schwimmbot-create/combat-robot-v2/artifacts/config-ui-live-viewing.png

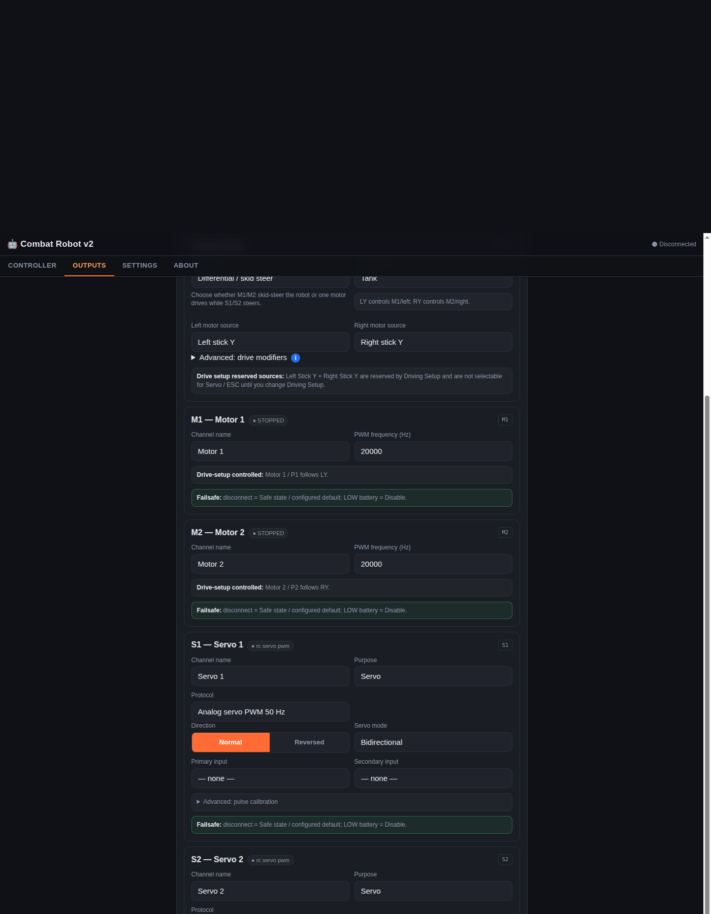
artifacts/config-ui-live-viewing.png
