schwimmbot-create/combat-robot-v2/artifacts/config-ui-sw1-failsafe.png

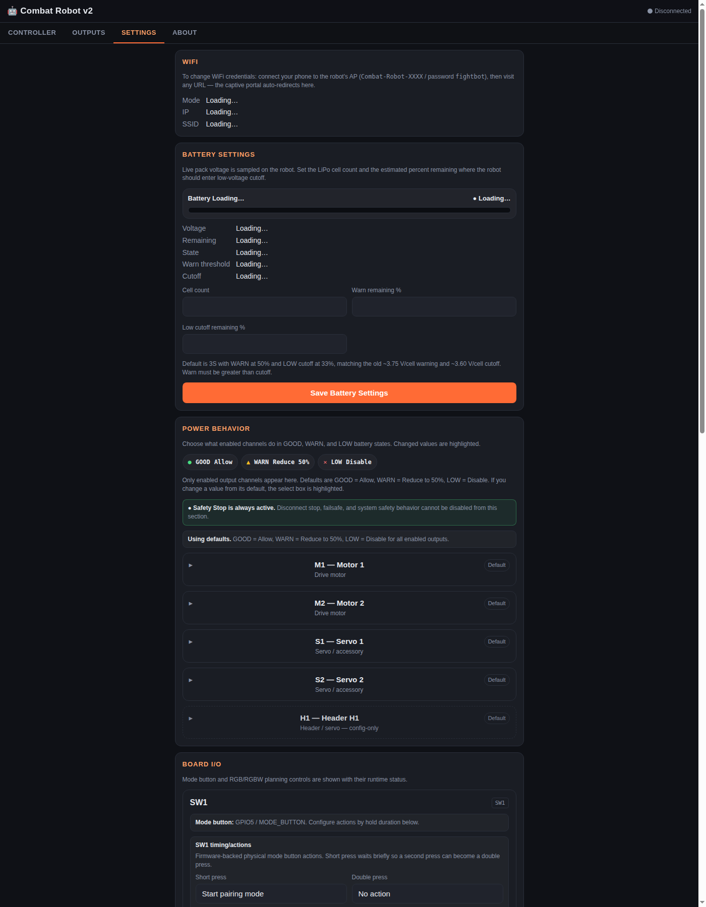
artifacts/config-ui-sw1-failsafe.png
