schwimmbot-create/combat-robot-v2/artifacts/drive-sim/bench-live.png

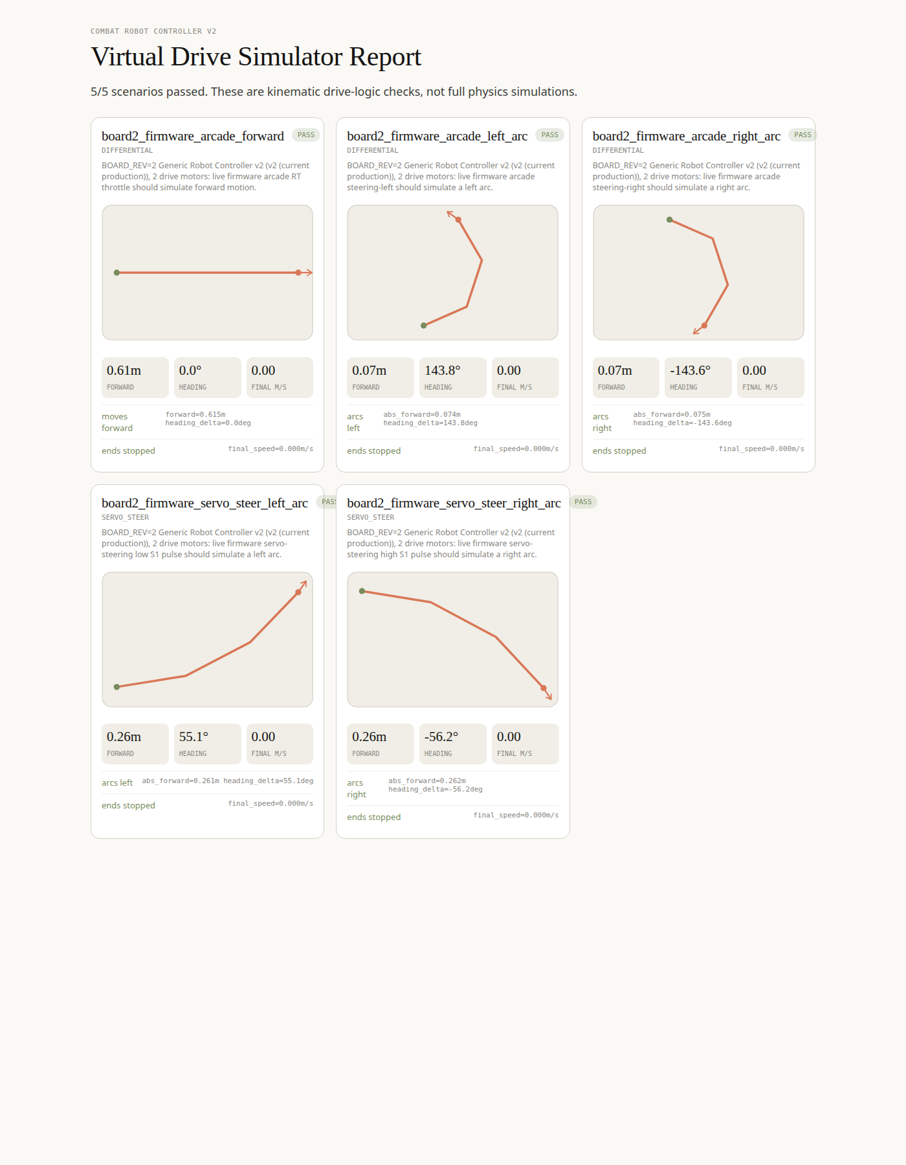
artifacts/drive-sim/bench-live.png
