schwimmbot-create/combat-robot-v2/artifacts/drive-sim/board-rev2.png

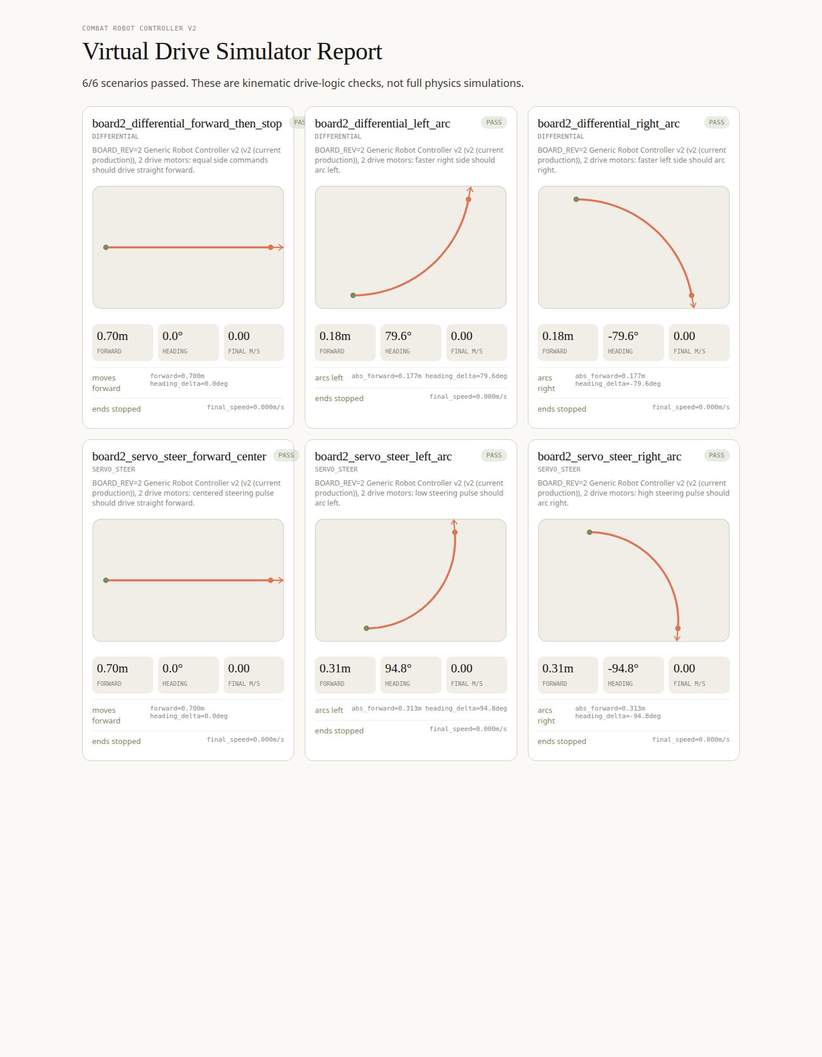
artifacts/drive-sim/board-rev2.png
