schwimmbot-create/combat-robot-v2/artifacts/drive-sim/latest.png

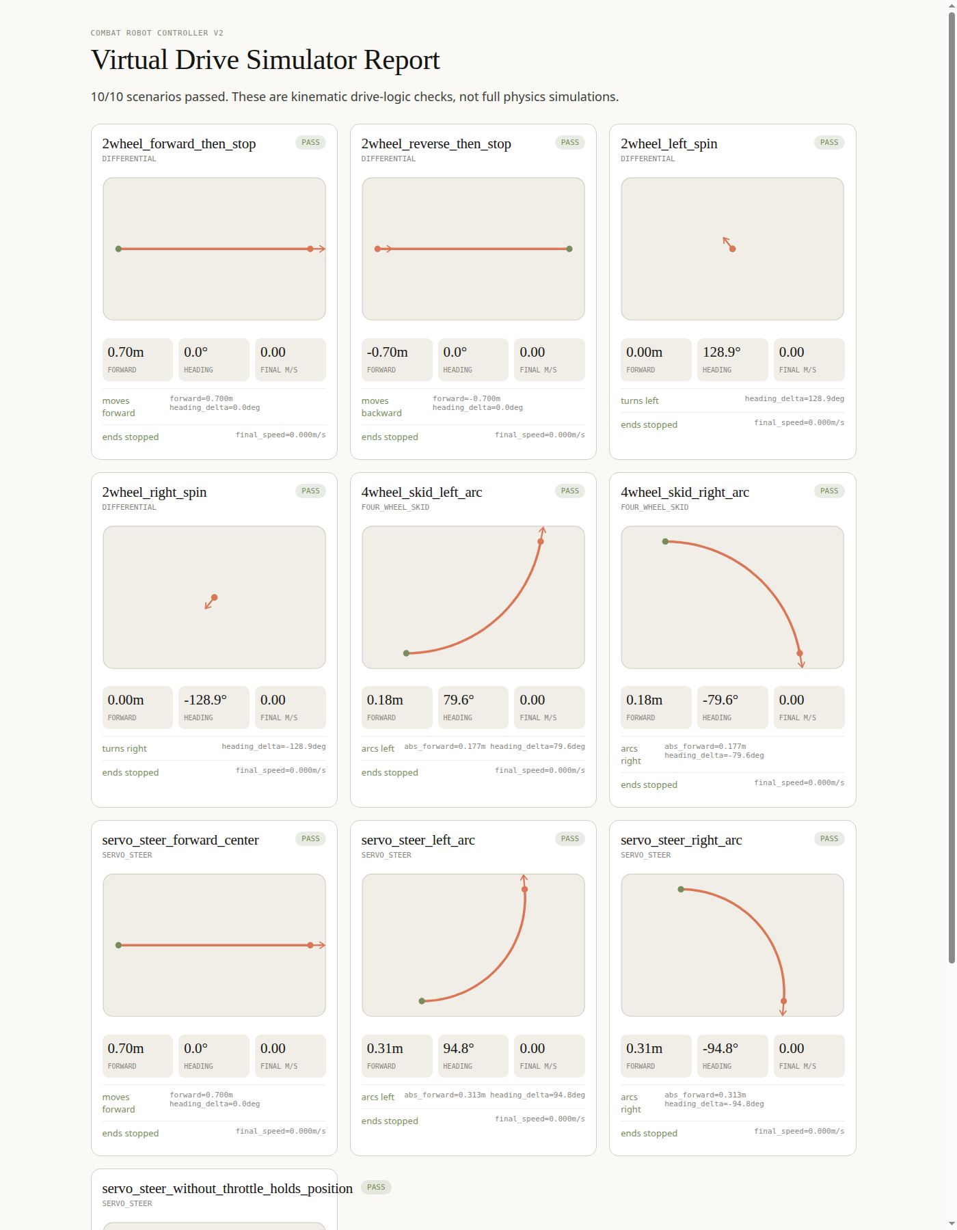
artifacts/drive-sim/latest.png
