schwimmbot-create/combat-robot-v2/docs/python-drive-testing-visual.html

Combat Robot Controller v2 · Python Drive Testing

# What the Python robot drive testing looks like

The current Python bench is a hardware-in-the-loop test harness: it drives a mock 8BitDo controller, pushes config through the robot API, reads serial status from the real robot controller, and asserts that firmware intent matches expected drive, motor, servo, power, and failsafe behavior.

396

software tests passing

PASS

PlatformIO build + upload

PASS

hardware bench e2e

90%

logic confidence without scope

## Current Python bench loop

This is what tools/bench_e2e.py does today.

## What Python asserts now

implementedhardware-in-loop

- Controller decoding: sticks, triggers, buttons, D-pad.
- Drive mixer: arcade, tank, D-pad virtual axes, precision, brake.
- Motor intent: M1/M2 speed, dir, fwd_duty, rev_duty, freq.
- Manual motor modes: momentary and latching.
- Servo/ESC pulse intent: S1/S2 pulse_us, duty, arming phase.
- Battery power behavior: GOOD full, WARN reduced, LOW disabled.
- Failsafe: disconnect stops drive motors.

Important: this does not measure voltage/waveforms with a scope. It proves the firmware's internal decision and output intent on real hardware.

## What a test case looks like

inject RT=50%, LX=left
expect drive_throttle > 200
expect drive_steering < -450
expect M1/M2 different speeds

status:
  drive={left:-253,right:511}
  motors={
    M1:{speed:125,dir:forward},
    M2:{speed:255,dir:reverse}
  }

PASS drive left stick steering mixes M1/M2

## Physical-drive extension: the visual part

The next layer is not just Python assertions. Python drives the exact same input script while a human/video confirms physical movement on a stand or marked floor.

## How the physical Python script should feel

Python step

Telemetry expected

Human/video expected

forward 1s

M1/M2 nonzero, same logical drive direction

robot would move straight forward

left turn 1s

left/right commands differ or oppose

robot yaws/arcs left

brake

drive left/right = 0, M1/M2 stop

all wheels stop

WARN override

drive command approximately half

wheel speed visibly reduced

disconnect

M1/M2 stop

robot stops safely
