schwimmbot-create/combat-robot-v2/docs/python-drive-testing-visual.png

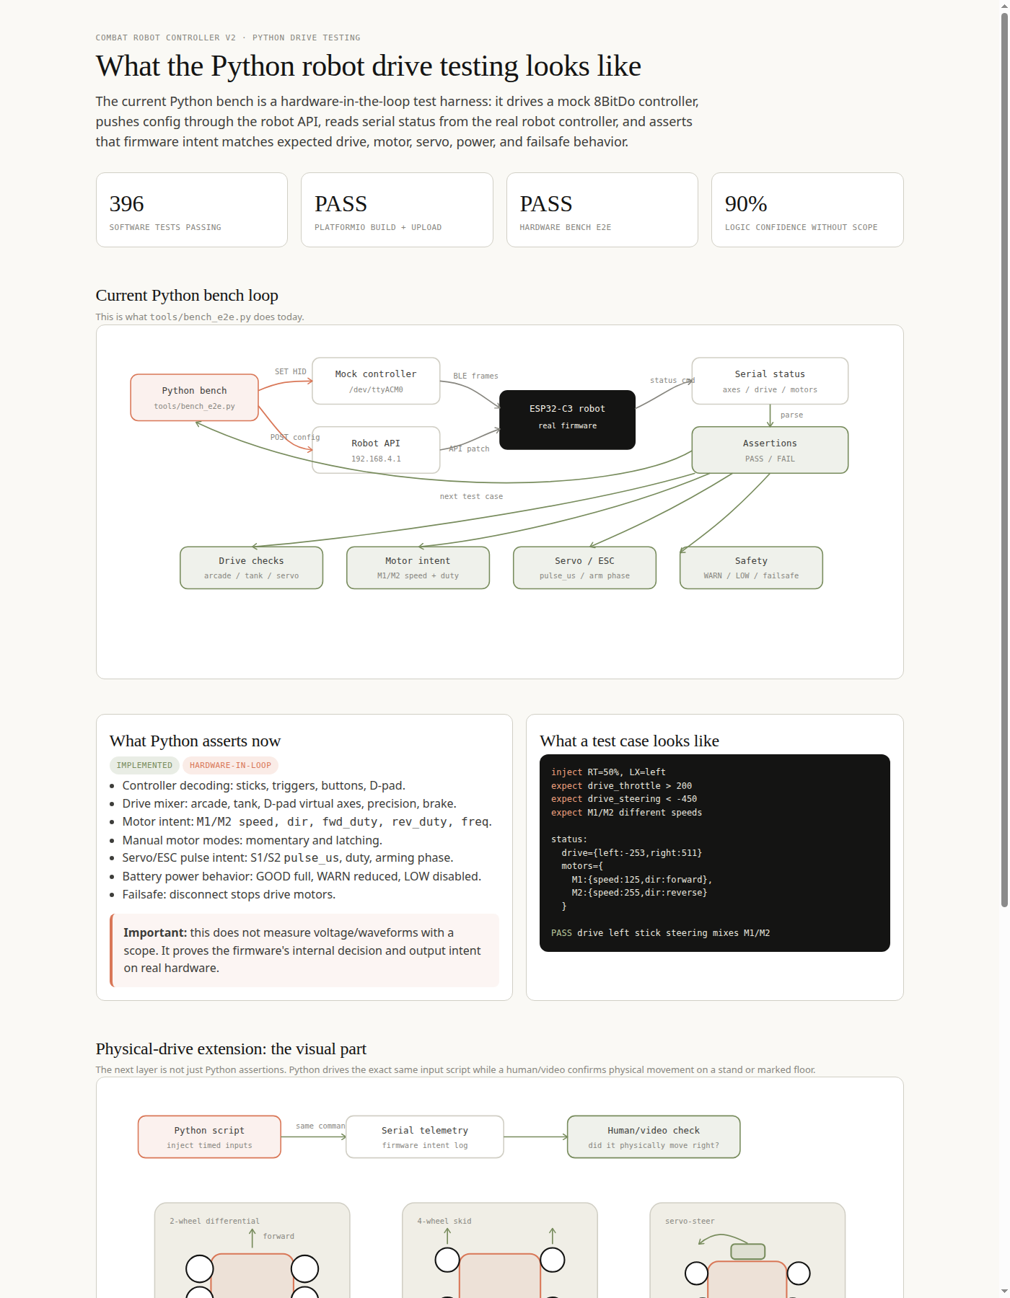
docs/python-drive-testing-visual.png
