schwimmbot-create/combat-robot-v2/hardware/board-v3-rev1-rendered.pdf

# USB Boot and Reset

3V3

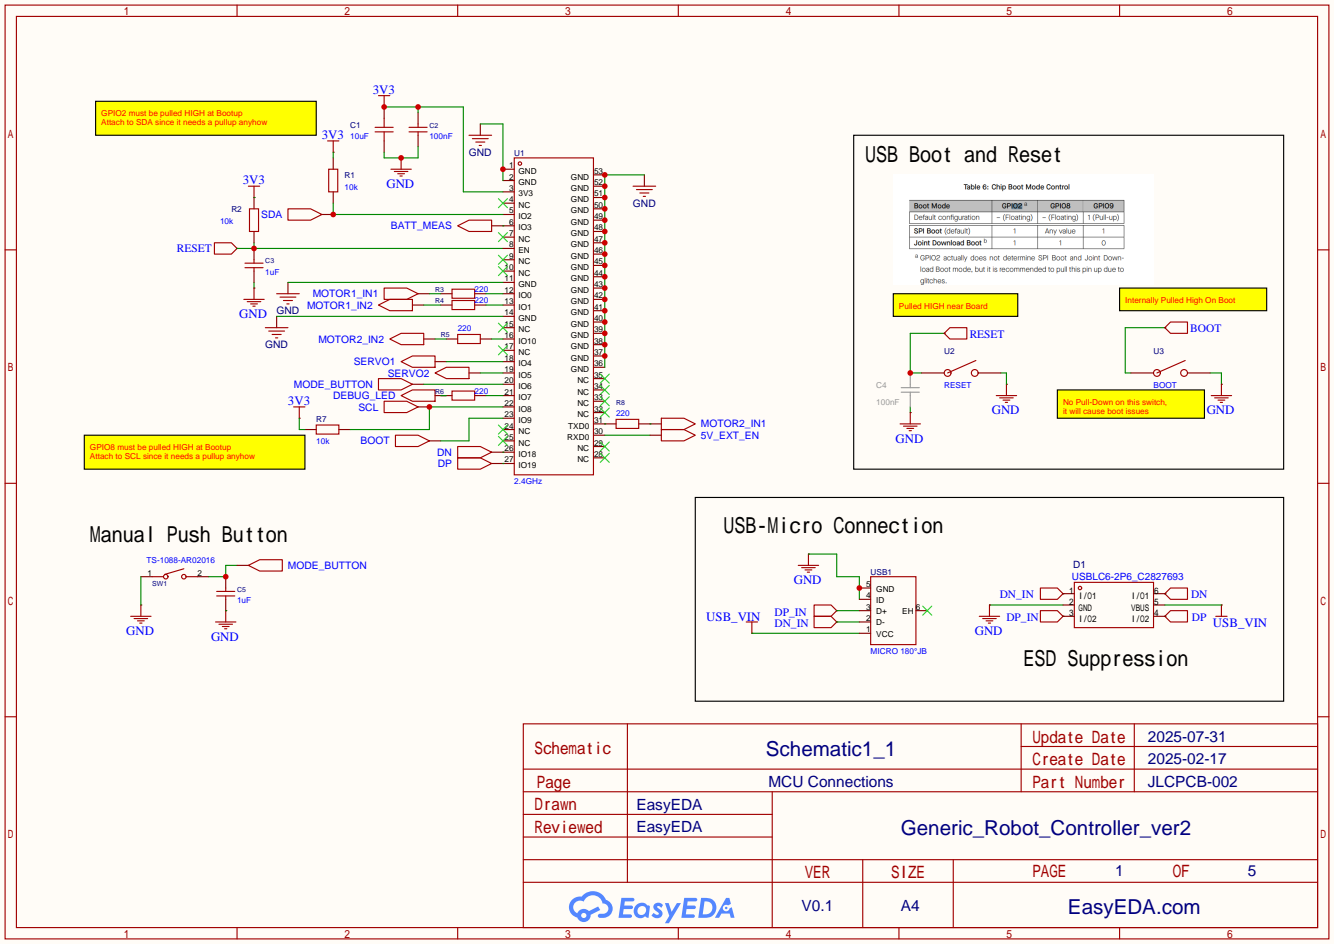
[picture p7: page 1]

GPIO2 must be pulled HIGH at Bootup
Attach to SDA since it needs a pullup anyhow

Pulled HIGH near Board

No Pull-Down on this switch,
it will cause boot issues

GPIO8 must be pulled HIGH at Bootup
Attach to SCL since it needs a pullup anyhow

# Battery Measurement WS2812 LED Supply

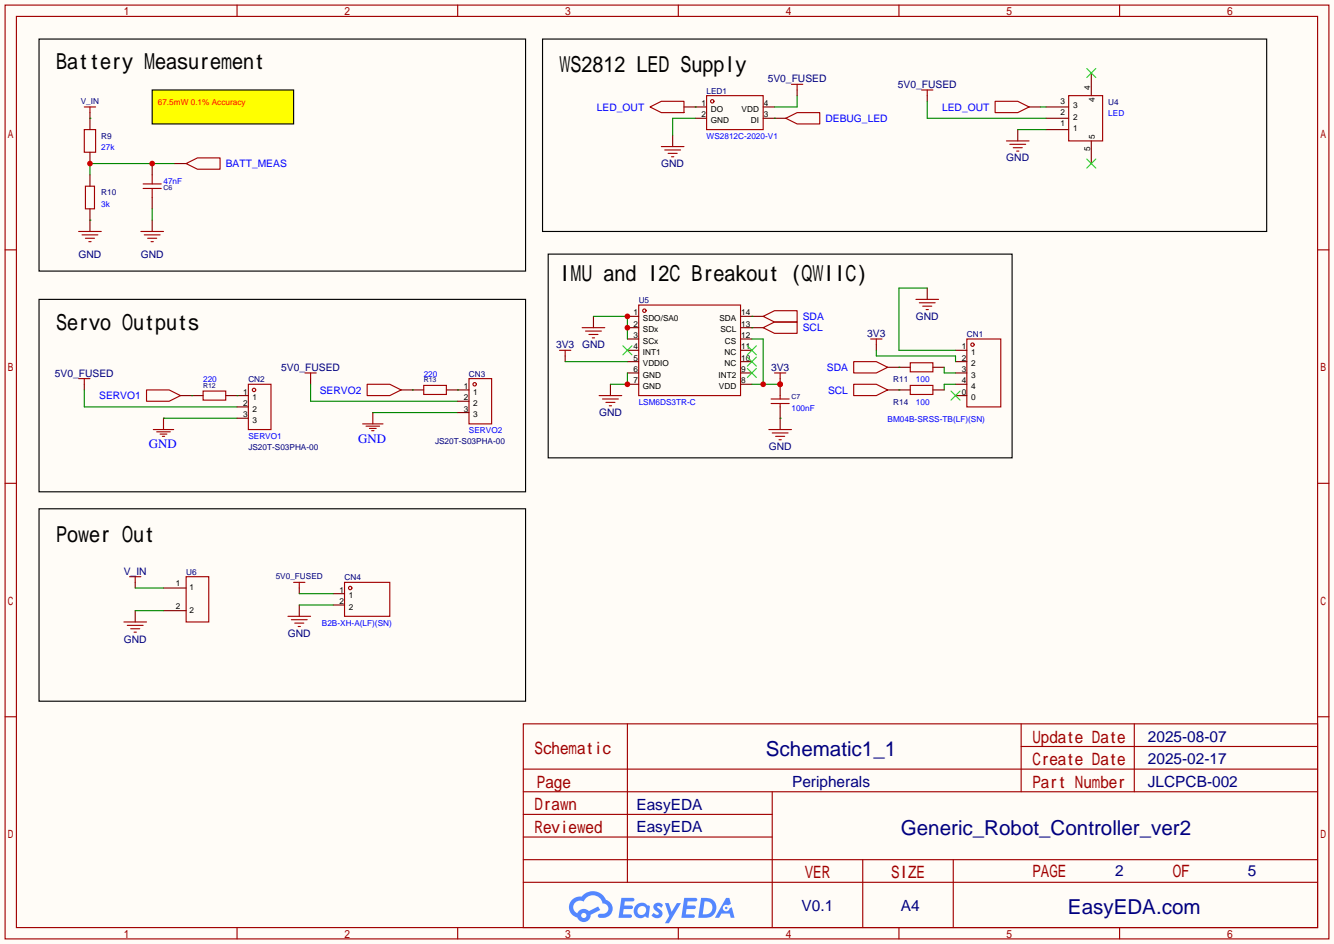
[picture p8: page 2]

IMU and I2C Breakout (QWIIC)

NC 10 NC 11 CS 12 SCL 13 SDA 14

BM04B-SRSS-TB(LF)(SN)

# Motor Drivers

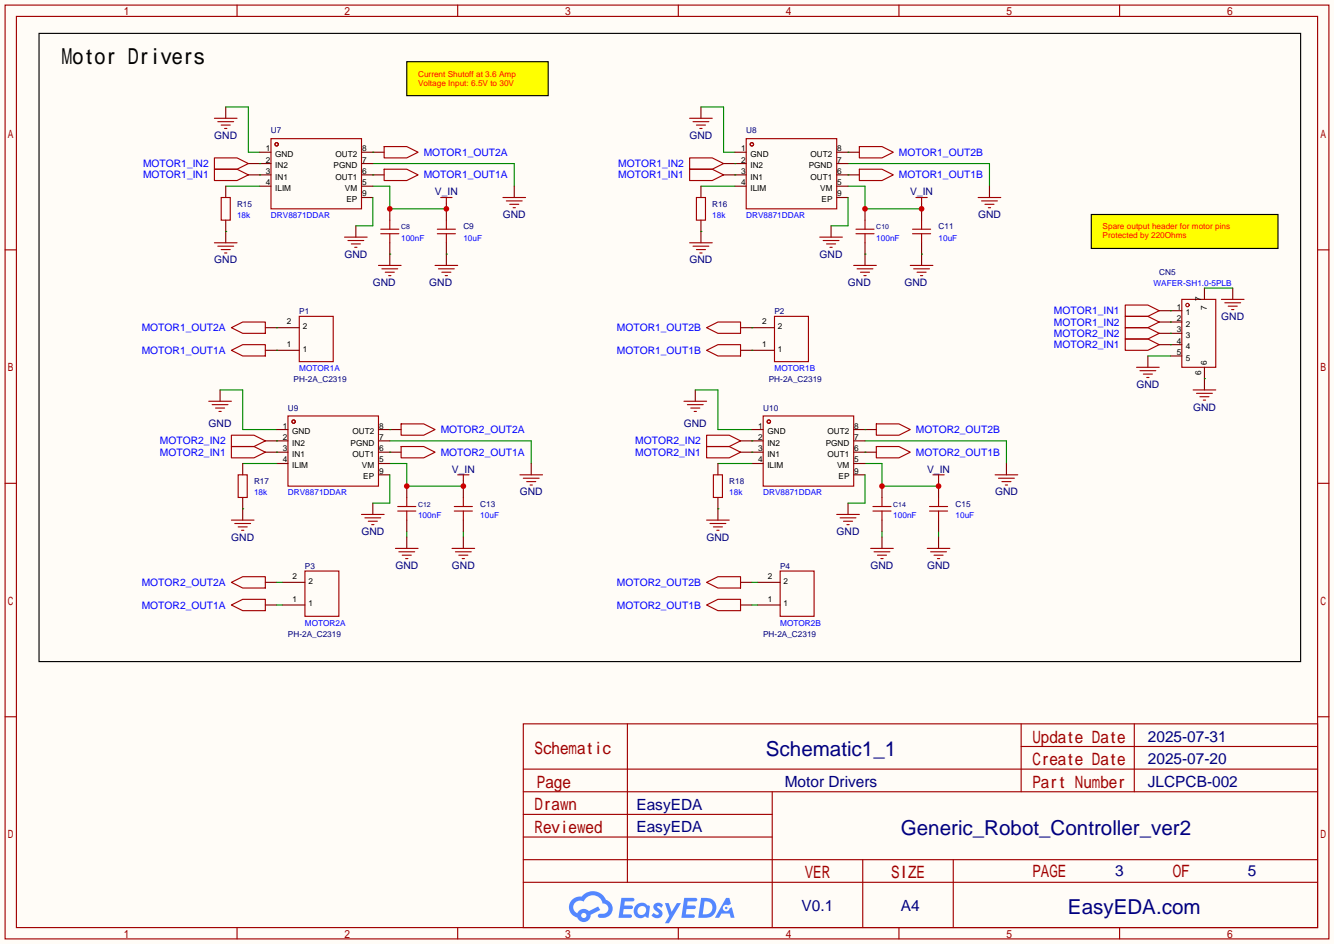
[picture p9: page 3]

Current Shutoff at 3.6 Amp
Voltage Input: 6.5V to 30V

Spare output header for motor pins
Protected by 220Ohms

# Power Protection

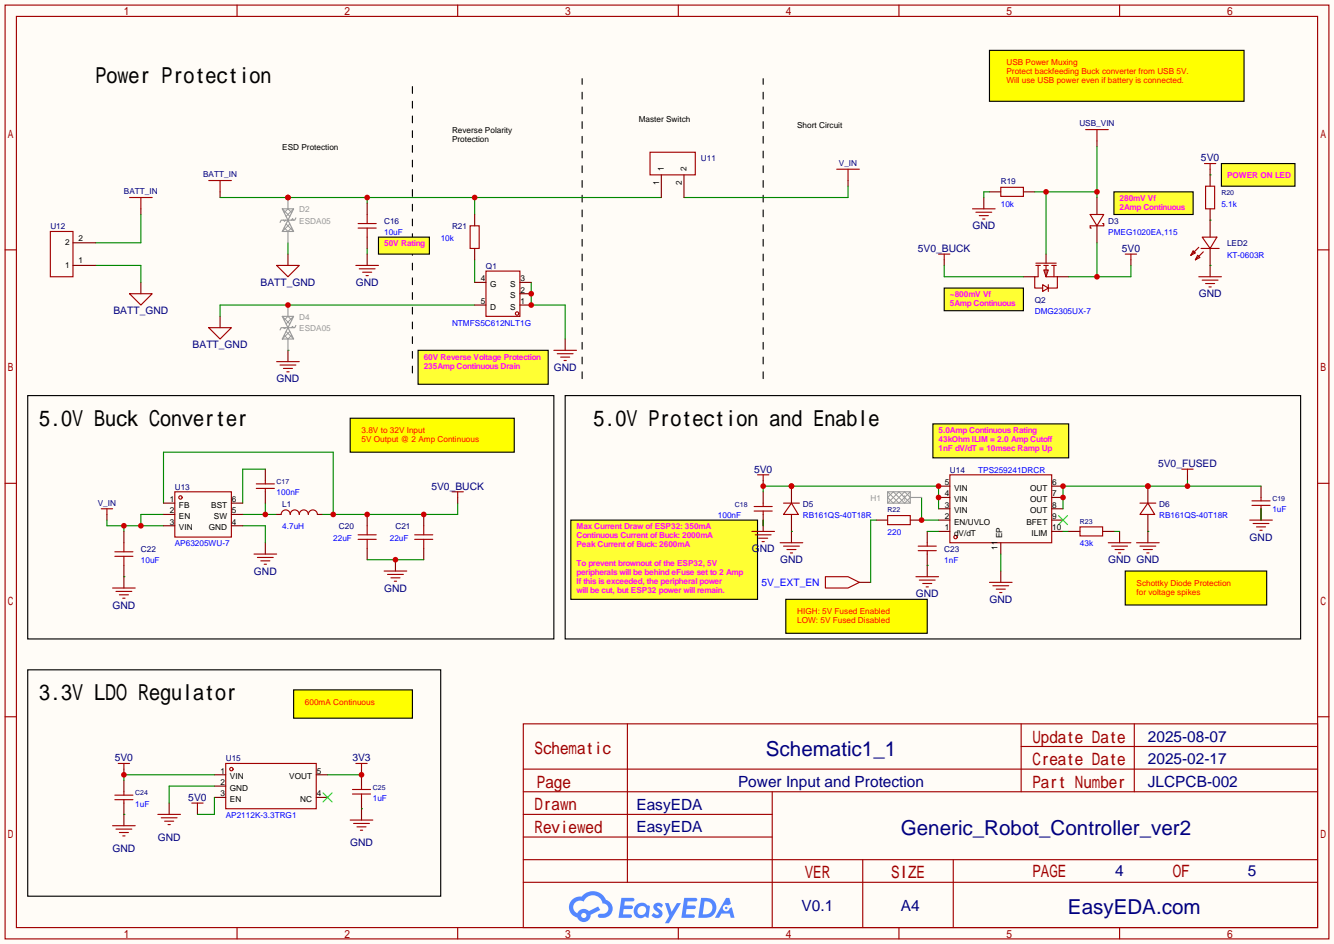
[picture p10: page 4]

USB Power Muxing
Protect backfeeding Buck converter from USB 5V.
Will use USB power even if battery is connected.

5.0Amp Continuous Rating
43kOhm ILIM = 2.0 Amp Cutoff
1nF dV/dT = 10msec Ramp Up

Max Current Draw of ESP32: 350mA
Continuous Current of Buck: 2000mA
Peak Current of Buck: 2600mA
To prevent brownout of the ESP32, 5V
peripherals will be behind eFuse set to 2 Amp
If this is exceeded, the peripheral power
will be cut, but ESP32 power will remain.

2025-02-17 Schematic1_1
Power Input and Protection

# 5.0V Buck Converter 5 Amp C26

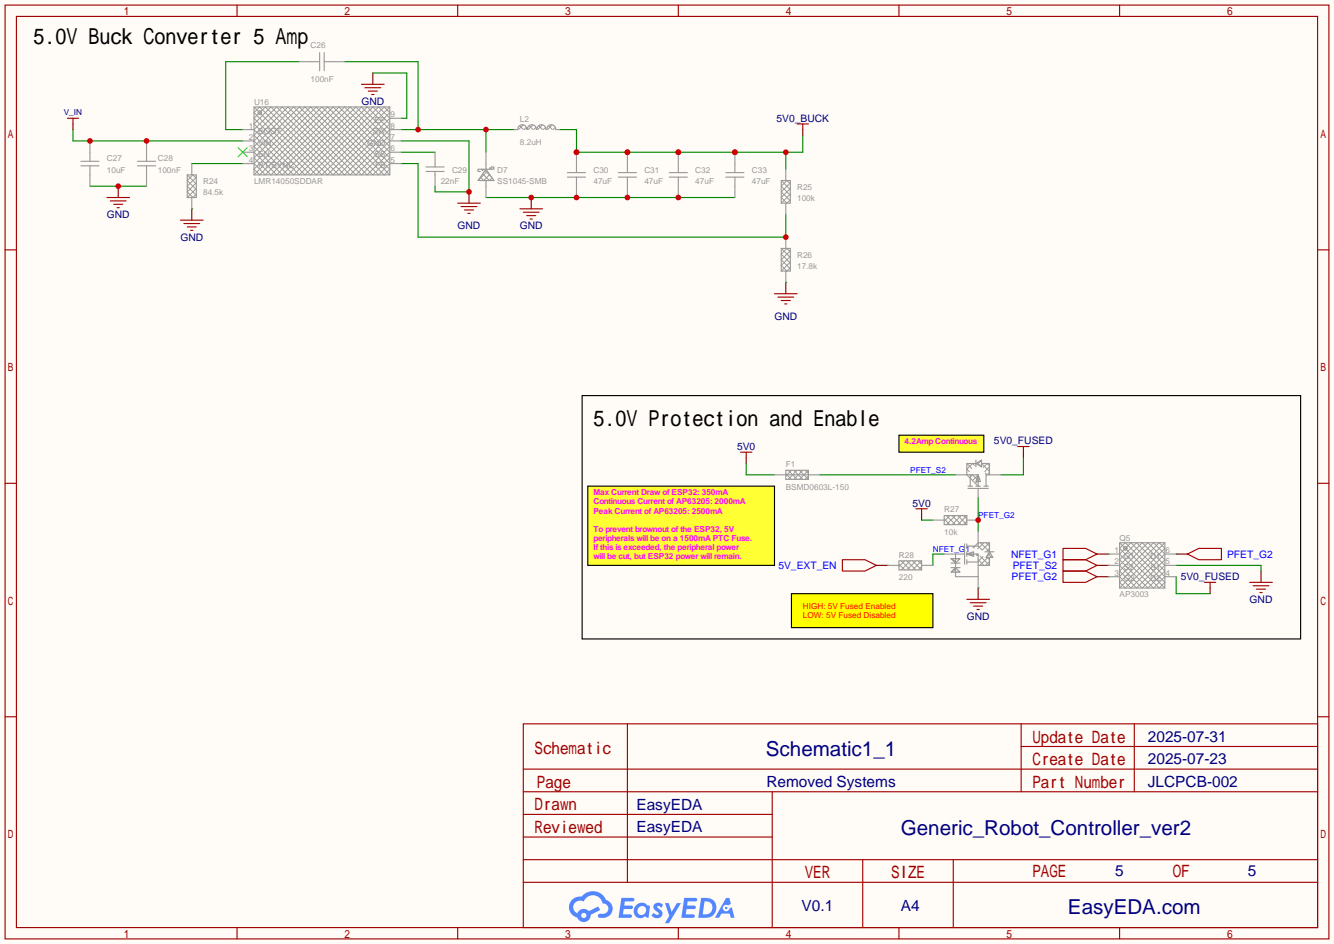
[picture p11: page 5]

Max Current Draw of ESP32: 350mA
Continuous Current of AP63205: 2000mA
Peak Current of AP63205: 2500mA
To prevent brownout of the ESP32, 5V
peripherals will be on a 1500mA PTC Fuse.
If this is exceeded, the peripheral power
will be cut, but ESP32 power will remain.
