schwimmbot-create/combat-robot-v2/(list of files, drawings)

Other design files:
hardware/board-v2-rev1-schematic.epro
hardware/board-v3-rev1-schematic.epro
