schwimmbot-create/combat-robot-v2/main/sketch.cpp

// sketch.cpp — Arduino setup() / loop() for combat robot v2.
//
// Replaces v1.3 Bluepad32 integration. Now:
//   * Reads gamepad state from ble_gamepad (NimBLE-backed)
//   * Feeds myrobot/TaskManager exactly the same way v1.3 did
//   * Polls the pairing button (MODE_BUTTON_PIN) to cycle states
//   * Initializes web_config (when implemented) for the HTML UI
//
// SPDX-License-Identifier: Apache-2.0

#include "sdkconfig.h"

#include <Arduino.h>
#include <WiFi.h>
#include <stdarg.h>
#include <stdio.h>
#include <string.h>
#include <ctype.h>
#include "esp_log.h"
#include "esp_task_wdt.h"
#include "esp_pm.h"
#include "nvs_flash.h"
#include "esp_event.h"
#include "esp_netif.h"

#include "Constants.h"
#include "TaskManager.h"

#include "ble_gamepad.h"
#include "web_config.h"
#include "output_config.h"

static const char *TAG = "Main";

static void boot_trace(const char *msg) {
    if (Serial) {
        Serial.printf("[BOOT %lu] %s\r\n", (unsigned long)millis(), msg);
    }
    ESP_LOGI(TAG, "%s", msg);
}

static void boot_tracef(const char *fmt, ...) {
    char buf[160];
    va_list ap;
    va_start(ap, fmt);
    vsnprintf(buf, sizeof(buf), fmt, ap);
    va_end(ap);
    boot_trace(buf);
}

ControllerState controllerState;   // shared with myrobot/TaskManager

TaskManager taskManager;

// Native USB-CDC host-control override. A host sends `usb control` frames
// over the same USB serial connection used for logs. Frames expire quickly
// unless refreshed, so unplugging/stalling the host returns the board to the
// normal BLE disconnect failsafe instead of holding a command indefinitely.
static bool g_usb_control_active = false;
static ControllerState g_usb_controller{};
static uint32_t g_usb_last_frame_ms = 0;
static constexpr uint32_t USB_CONTROL_TIMEOUT_MS = 250;

// --- Pairing mode button ----------------------------------------------
//
// The MODE_BUTTON_PIN (GPIO5 on C3) is already used by Buttons.cpp for
// short/long press events driving TaskManager. We layer pairing-mode
// toggles on top:
//   - Single short press: cycle to next pairing state
//     (IDLE -> ACCEPT -> IDLE)
//   - Long press (>3s) in ACCEPT mode: clear whitelist + stay in ACCEPT
//
// Note: in v1.3 this was driven by the Arduino loop. We keep that
// pattern; web UI can also drive the same state via the public API.

static void handle_pairing_button(void) {
    // NOTE: this hook point will be wired into the existing Buttons
    // class once we finalize the button event surface. For the first
    // cut, we leave the API surface (ble_gamepad_set_pairing_state)
    // ready and let the web UI drive pairing.
    //
    // Implementation deferred to LATER: see docs/TESTING.md.
}

// --- LED1 pairing indicator --------------------------------------------
//
// LED1 (DEBUG_LED_PIN) is the v2 board's standard LED, wired to the LED
// class in TaskManager for morse-code patterns. That class can't be
// driven from the NimBLE pairing callback because the LED's pattern
// task only knows about enqueuePattern(). For the simple binary
// "pairing / connected / idle" indicator we want here, driving the pin
// directly is cleaner. Behavior:
//   * PAIRING_STATE_ACCEPT  : 250ms on / 250ms off blink
//   * controller connected : solid ON
//   * otherwise            : OFF
// The pairing state machine drives ACCEPT <-> IDLE, and the existing
// on_ble_connection_change callback in web_config mirrors the
// connected state. We watch both at 20ms cadence to keep the LED
// output stable against rapid re-entry into pairing.

static volatile bool g_pairing_led_active = false;
static volatile bool g_connected_led_active = false;
static TaskHandle_t g_led1_task = nullptr;
static portMUX_TYPE g_led1_lock = portMUX_INITIALIZER_UNLOCKED;

static void led1_indicator_task(void *pvParameters) {
    (void)pvParameters;
    pinMode(DEBUG_LED_PIN, OUTPUT);
    digitalWrite(DEBUG_LED_PIN, LOW);
    bool on = false;
    TickType_t last = xTaskGetTickCount();
    for (;;) {
        bool pairing;
        bool connected;
        portENTER_CRITICAL(&g_led1_lock);
        pairing = g_pairing_led_active;
        connected = g_connected_led_active;
        portEXIT_CRITICAL(&g_led1_lock);

        if (pairing) {
            // 250ms on / 250ms off. Half-period tick is 250ms; we flip
            // the LED each tick, so duty = 50%.
            TickType_t now = xTaskGetTickCount();
            if (now - last >= pdMS_TO_TICKS(250)) {
                last = now;
                on = !on;
                digitalWrite(DEBUG_LED_PIN, on ? HIGH : LOW);
            }
        } else {
            // Reset the phase so the next entry into pairing always
            // starts on a clean 250ms tick.
            on = true;
            last = xTaskGetTickCount();
            digitalWrite(DEBUG_LED_PIN, connected ? HIGH : LOW);
        }
        vTaskDelay(pdMS_TO_TICKS(20));
    }
}

static void on_pairing_state_change(PairingState state) {
    portENTER_CRITICAL(&g_led1_lock);
    g_pairing_led_active = (state == PAIRING_STATE_ACCEPT);
    portEXIT_CRITICAL(&g_led1_lock);
}

// Called from the existing on_ble_connection_change path in
// web_config via a thin shim. The shim lives in this TU so the
// web_config component does not have to know about LED1.
// Exposed as a C symbol with C linkage so the web_config archive
// can resolve the reference during the static-library link pass
// (it is compiled before sketch.cpp). The body in this TU is the
// real implementation; a weak fallback also lives in web_config
// so non-sketch builds still link.
extern "C" void main_notify_connected(bool connected) {
    portENTER_CRITICAL(&g_led1_lock);
    g_connected_led_active = connected;
    portEXIT_CRITICAL(&g_led1_lock);
}

extern "C" bool main_get_digital_output_logical(int output_id) {
    return taskManager.getDigitalOutputLogical((oc_output_id_t)output_id);
}

extern "C" bool main_get_digital_output_physical_high(int output_id) {
    return taskManager.getDigitalOutputPhysicalHigh((oc_output_id_t)output_id);
}

static const char* runtime_purpose_name(oc_purpose_t p) {
    switch (p) {
        case OC_PURPOSE_DRIVE: return "drive"; case OC_PURPOSE_SERVO: return "servo";
        case OC_PURPOSE_ESC: return "esc"; case OC_PURPOSE_DIGITAL_OUTPUT: return "digital_output";
        case OC_PURPOSE_DIGITAL_INPUT: return "digital_input"; case OC_PURPOSE_PWM_ACCESSORY: return "pwm_accessory";
        case OC_PURPOSE_RGB_LIGHTING: return "rgb_lighting"; default: return "disabled";
    }
}

extern "C" int main_build_runtime_output_json(char *buf, size_t len) {
    if (!buf || len < 128) return -1;
    DriveMotorIntent m1 = taskManager.getMotorIntent(OC_OUT_M1);
    DriveMotorIntent m2 = taskManager.getMotorIntent(OC_OUT_M2);
    const oc_output_cfg_t* c1 = output_config_get(OC_OUT_M1);
    const oc_output_cfg_t* c2 = output_config_get(OC_OUT_M2);
    const oc_output_cfg_t* s1 = output_config_get(OC_OUT_S1);
    const oc_output_cfg_t* s2 = output_config_get(OC_OUT_S2);
    const oc_drive_setup_t* drive = output_config_get_drive_setup();
    int n = snprintf(buf, len,
        "{\"outputs\":{"
        "\"M1\":{\"purpose\":\"%s\",\"speed\":%u,\"direction\":%u,\"fwd_duty\":%u,\"rev_duty\":%u,\"frequency_hz\":%u,\"allowed\":%s,\"blocked_reason\":\"%s\"},"
        "\"M2\":{\"purpose\":\"%s\",\"speed\":%u,\"direction\":%u,\"fwd_duty\":%u,\"rev_duty\":%u,\"frequency_hz\":%u,\"allowed\":%s,\"blocked_reason\":\"%s\"},"
        "\"S1\":{\"purpose\":\"%s\",\"pulse_us\":%u,\"duty\":%u,\"logical\":%s,\"physical_high\":%s,\"esc_arm_phase\":\"%s\",\"allowed\":%s,\"blocked_reason\":\"%s\"},"
        "\"S2\":{\"purpose\":\"%s\",\"pulse_us\":%u,\"duty\":%u,\"logical\":%s,\"physical_high\":%s,\"esc_arm_phase\":\"%s\",\"allowed\":%s,\"blocked_reason\":\"%s\"}},"
        "\"drive\":{\"layout\":\"%s\",\"method\":\"%s\",\"throttle\":%d,\"steering\":%d,\"left_command\":%d,\"right_command\":%d}}",
        runtime_purpose_name(c1->purpose),m1.speed,m1.direction,m1.fwd_duty,m1.rev_duty,m1.frequency_hz,strcmp(taskManager.getOutputBlockedReason(OC_OUT_M1),"none")==0?"true":"false",taskManager.getOutputBlockedReason(OC_OUT_M1),
        runtime_purpose_name(c2->purpose),m2.speed,m2.direction,m2.fwd_duty,m2.rev_duty,m2.frequency_hz,strcmp(taskManager.getOutputBlockedReason(OC_OUT_M2),"none")==0?"true":"false",taskManager.getOutputBlockedReason(OC_OUT_M2),
        runtime_purpose_name(s1->purpose),taskManager.getAuxPulseUs(OC_OUT_S1),taskManager.getAuxDuty(OC_OUT_S1),taskManager.getDigitalOutputLogical(OC_OUT_S1)?"true":"false",taskManager.getDigitalOutputPhysicalHigh(OC_OUT_S1)?"true":"false",taskManager.getEscArmPhaseName(OC_OUT_S1),strcmp(taskManager.getOutputBlockedReason(OC_OUT_S1),"none")==0?"true":"false",taskManager.getOutputBlockedReason(OC_OUT_S1),
        runtime_purpose_name(s2->purpose),taskManager.getAuxPulseUs(OC_OUT_S2),taskManager.getAuxDuty(OC_OUT_S2),taskManager.getDigitalOutputLogical(OC_OUT_S2)?"true":"false",taskManager.getDigitalOutputPhysicalHigh(OC_OUT_S2)?"true":"false",taskManager.getEscArmPhaseName(OC_OUT_S2),strcmp(taskManager.getOutputBlockedReason(OC_OUT_S2),"none")==0?"true":"false",taskManager.getOutputBlockedReason(OC_OUT_S2),
        output_config_drive_layout_name(drive->layout),output_config_drive_method_name(drive->method),taskManager.getDriveThrottle(),taskManager.getDriveSteering(),taskManager.getDriveLeftCommand(),taskManager.getDriveRightCommand());
    return n > 0 && (size_t)n < len ? n : -1;
}

// --- Connection state callback ----------------------------------------
//
// ble_gamepad fires on_ble_connection_change on every connect/disconnect.
// There is no per-TU callback chain yet, so the *single* registration
// site is web_config_init() in components/web_config/src/web_config.cpp
// (which sets s_gp.broadcast_pending and logs connect/disconnect). If
// you need to add additional handlers here, extend
// ble_gamepad_set_connection_callback to support a list, then register
// each listener from its own TU.

// --- Serial CLI -------------------------------------------------------
//
// Line-oriented control surface for bench/dev use when the web AP is not
// reachable from the test host. Commands are intentionally tiny and stable:
//   help | status | pair start | pair cancel | pair clear | disconnect
//   bench status | bench enable | bench disable | bench hid <hex>

static const char *pairing_state_name(PairingState state) {
    switch (state) {
        case PAIRING_STATE_IDLE:     return "IDLE";
        case PAIRING_STATE_ACCEPT:   return "ACCEPT";
        case PAIRING_STATE_DISABLED: return "DISABLED";
        default:                     return "UNKNOWN";
    }
}

static const char *motor_direction_name(byte direction) {
    switch (direction) {
        case FORWARD: return "forward";
        case REVERSE: return "reverse";
        case STOP: return "stop";
        default: return "unknown";
    }
}

static void print_mac(const ble_mac_t &mac) {
    Serial.printf("%02x:%02x:%02x:%02x:%02x:%02x",
                  mac.addr[0], mac.addr[1], mac.addr[2],
                  mac.addr[3], mac.addr[4], mac.addr[5]);
}

static void cli_print_help(void) {
    Serial.println("CLI OK commands: help | status | pair start | pair cancel | pair clear | disconnect");
    Serial.println("CLI OK bench: bench status | bench enable | bench disable | bench hid <hex>");
    Serial.println("CLI OK USB: usb enable | usb disable | usb control <lx> <ly> <rx> <ry> <lt> <rt> <buttons> <dpad>");
    Serial.println("CLI OK hex accepts spaces, ':' or '-' separators; max 64 bytes");
}

static void cli_print_status(void) {
    ble_mac_t connected_mac{};
    bool connected = ble_gamepad_get_connected_mac(&connected_mac);
    ControllerState cs = ble_gamepad_get_state();
    Serial.printf("CLI STATUS pairing=%s connected=%d bench=%d max_paired=%u ",
                  pairing_state_name(ble_gamepad_get_pairing_state()),
                  connected ? 1 : 0,
                  ble_gamepad_bench_is_enabled() ? 1 : 0,
                  (unsigned)ble_gamepad_get_max_paired());
    Serial.print("connected_mac=");
    if (connected) print_mac(connected_mac); else Serial.print("none");
    Serial.printf(" axes={lx:%d,ly:%d,rx:%d,ry:%d,lt:%d,rt:%d,buttons:%u,dpad:%u}",
                  cs.leftStickX, cs.leftStickY, cs.rightStickX, cs.rightStickY,
                  cs.leftTrigger, cs.rightTrigger, (unsigned)cs.buttons, (unsigned)cs.dpad);
    Serial.printf(" outputs={S1:{logical:%d,physical_high:%d,pulse_us:%u,duty:%u,arm:%s},S2:{logical:%d,physical_high:%d,pulse_us:%u,duty:%u,arm:%s}}",
                  taskManager.getDigitalOutputLogical(OC_OUT_S1) ? 1 : 0,
                  taskManager.getDigitalOutputPhysicalHigh(OC_OUT_S1) ? 1 : 0,
                  (unsigned)taskManager.getAuxPulseUs(OC_OUT_S1),
                  (unsigned)taskManager.getAuxDuty(OC_OUT_S1),
                  taskManager.getEscArmPhaseName(OC_OUT_S1),
                  taskManager.getDigitalOutputLogical(OC_OUT_S2) ? 1 : 0,
                  taskManager.getDigitalOutputPhysicalHigh(OC_OUT_S2) ? 1 : 0,
                  (unsigned)taskManager.getAuxPulseUs(OC_OUT_S2),
                  (unsigned)taskManager.getAuxDuty(OC_OUT_S2),
                  taskManager.getEscArmPhaseName(OC_OUT_S2));
    const oc_drive_setup_t* driveSetup = output_config_get_drive_setup();
    Serial.printf(" drive={layout:%s,method:%s,throttle_axis:%s,steering_axis:%s,throttle:%d,steering:%d,left:%d,right:%d}",
                  output_config_drive_layout_name(driveSetup->layout),
                  output_config_drive_method_name(driveSetup->method),
                  output_config_drive_axis_name(driveSetup->throttle_axis),
                  output_config_drive_axis_name(driveSetup->steering_axis),
                  taskManager.getDriveThrottle(),
                  taskManager.getDriveSteering(),
                  taskManager.getDriveLeftCommand(),
                  taskManager.getDriveRightCommand());
    DriveMotorIntent m1 = taskManager.getMotorIntent(OC_OUT_M1);
    DriveMotorIntent m2 = taskManager.getMotorIntent(OC_OUT_M2);
    Serial.printf(" motors={M1:{speed:%u,dir:%s,fwd_duty:%u,rev_duty:%u,freq:%u},M2:{speed:%u,dir:%s,fwd_duty:%u,rev_duty:%u,freq:%u}}",
                  (unsigned)m1.speed, motor_direction_name(m1.direction),
                  (unsigned)m1.fwd_duty, (unsigned)m1.rev_duty, (unsigned)m1.frequency_hz,
                  (unsigned)m2.speed, motor_direction_name(m2.direction),
                  (unsigned)m2.fwd_duty, (unsigned)m2.rev_duty, (unsigned)m2.frequency_hz);
    Serial.print(" paired=[");
    ble_mac_t macs[BLE_MAX_PAIRED_CONTROLLERS];
    uint8_t count = BLE_MAX_PAIRED_CONTROLLERS;
    ble_gamepad_get_paired_macs(macs, &count);
    for (uint8_t i = 0; i < count; i++) {
        if (i) Serial.print(",");
        print_mac(macs[i]);
    }
    Serial.println("]");
}

static int cli_hexval(char c) {
    if (c >= '0' && c <= '9') return c - '0';
    if (c >= 'a' && c <= 'f') return c - 'a' + 10;
    if (c >= 'A' && c <= 'F') return c - 'A' + 10;
    return -1;
}

static bool cli_parse_hex(const char *s, uint8_t *out, size_t out_cap, size_t *out_len) {
    int hi = -1;
    size_t n = 0;
    for (; *s; s++) {
        if (*s == ' ' || *s == '\t' || *s == ':' || *s == '-') continue;
        int v = cli_hexval(*s);
        if (v < 0) return false;
        if (hi < 0) {
            hi = v;
        } else {
            if (n >= out_cap) return false;
            out[n++] = (uint8_t)((hi << 4) | v);
            hi = -1;
        }
    }
    if (hi >= 0 || n == 0) return false;
    *out_len = n;
    return true;
}

static void cli_execute(char *line) {
    while (*line && isspace((unsigned char)*line)) line++;
    size_t len = strlen(line);
    while (len && isspace((unsigned char)line[len - 1])) line[--len] = '\0';
    if (len == 0) return;

    if (strcmp(line, "help") == 0 || strcmp(line, "?") == 0) {
        cli_print_help();
    } else if (strcmp(line, "status") == 0) {
        cli_print_status();
    } else if (strcmp(line, "pair start") == 0) {
        esp_err_t err = ble_gamepad_set_pairing_state(PAIRING_STATE_ACCEPT);
        Serial.printf("CLI %s pair start err=0x%x\r\n", err == ESP_OK ? "OK" : "ERR", (unsigned)err);
    } else if (strcmp(line, "pair cancel") == 0) {
        esp_err_t err = ble_gamepad_set_pairing_state(PAIRING_STATE_IDLE);
        Serial.printf("CLI %s pair cancel err=0x%x\r\n", err == ESP_OK ? "OK" : "ERR", (unsigned)err);
    } else if (strcmp(line, "pair clear") == 0) {
        esp_err_t err = ble_gamepad_clear_paired_macs();
        Serial.printf("CLI %s pair clear err=0x%x\r\n", err == ESP_OK ? "OK" : "ERR", (unsigned)err);
    } else if (strcmp(line, "disconnect") == 0) {
        esp_err_t err = ble_gamepad_disconnect();
        Serial.printf("CLI %s disconnect err=0x%x\r\n", err == ESP_OK ? "OK" : "ERR", (unsigned)err);
    } else if (strcmp(line, "usb enable") == 0) {
        g_usb_control_active = true;
        g_usb_controller = ControllerState{};
        g_usb_last_frame_ms = millis();
        Serial.println("CLI OK usb enabled timeout_ms=250");
    } else if (strcmp(line, "usb disable") == 0) {
        g_usb_control_active = false;
        g_usb_controller = ControllerState{};
        Serial.println("CLI OK usb disabled");
    } else if (strncmp(line, "usb control ", 12) == 0) {
        int lx, ly, rx, ry, lt, rt, buttons, dpad;
        if (sscanf(line + 12, "%d %d %d %d %d %d %d %d", &lx, &ly, &rx, &ry, &lt, &rt, &buttons, &dpad) != 8 ||
            lx < -512 || lx > 511 || ly < -512 || ly > 511 || rx < -512 || rx > 511 || ry < -512 || ry > 511 ||
            lt < 0 || lt > 1023 || rt < 0 || rt > 1023 || buttons < 0 || buttons > 65535 || dpad < 0 || dpad > 8) {
            Serial.println("CLI ERR usb control range_or_format");
            return;
        }
        g_usb_controller = {lx, ly, rx, ry, rt, lt, (uint16_t)buttons, (uint16_t)dpad};
        g_usb_control_active = true;
        g_usb_last_frame_ms = millis();
        Serial.println("CLI OK usb control accepted");
    } else if (strcmp(line, "bench status") == 0) {
        Serial.printf("CLI OK bench build=1 enabled=%d\r\n", ble_gamepad_bench_is_enabled() ? 1 : 0);
    } else if (strcmp(line, "bench enable") == 0) {
        esp_err_t err = ble_gamepad_bench_set_enabled(true);
        Serial.printf("CLI %s bench enable err=0x%x\r\n", err == ESP_OK ? "OK" : "ERR", (unsigned)err);
    } else if (strcmp(line, "bench disable") == 0) {
        esp_err_t err = ble_gamepad_bench_set_enabled(false);
        Serial.printf("CLI %s bench disable err=0x%x\r\n", err == ESP_OK ? "OK" : "ERR", (unsigned)err);
    } else if (strncmp(line, "bench hid ", 10) == 0) {
        uint8_t buf[64];
        size_t n = 0;
        if (!cli_parse_hex(line + 10, buf, sizeof(buf), &n)) {
            Serial.println("CLI ERR bench hid bad_hex");
            return;
        }
        esp_err_t err = ble_gamepad_bench_inject_hid_report(buf, (uint16_t)n);
        Serial.printf("CLI %s bench hid len=%u err=0x%x\r\n", err == ESP_OK ? "OK" : "ERR", (unsigned)n, (unsigned)err);
    } else {
        Serial.printf("CLI ERR unknown command: %s\r\n", line);
        cli_print_help();
    }
}

static void cli_poll(void) {
    static char line[160];
    static size_t pos = 0;
    while (Serial.available() > 0) {
        char c = (char)Serial.read();
        if (c == '\r') continue;
        if (c == '\n') {
            line[pos] = '\0';
            cli_execute(line);
            pos = 0;
        } else if (pos + 1 < sizeof(line)) {
            line[pos++] = c;
        } else {
            pos = 0;
            Serial.println("CLI ERR line_too_long");
        }
    }
}

// --- Arduino lifecycle ------------------------------------------------

void setup() {
    Serial.begin(115200);
    Serial.setDebugOutput(true);
    delay(300);
    boot_trace("setup begin");

    // Disable automatic light sleep (matches v1.3 behavior; required
    // because RMT (NeoPixel) doesn't coexist with light sleep on C3).
    esp_pm_lock_handle_t pm_lock;
    boot_trace("pm lock create");
    esp_pm_lock_create(ESP_PM_NO_LIGHT_SLEEP, 0, "no_light_sleep", &pm_lock);
    esp_pm_lock_acquire(pm_lock);
    boot_trace("pm lock acquired");

    // Verbose logging for development; drop to INFO for production.
    esp_log_level_set("*", ESP_LOG_INFO);

    boot_tracef("Robot Firmware: %s", VERSION);
    boot_trace("BLE stack: NimBLE (replaces Bluepad32)");

    // NVS must be initialized before any component that uses it.
    // ble_gamepad uses NVS for the MAC whitelist; web_config uses it
    // for WiFi credentials.
    boot_trace("nvs init begin");
    esp_err_t err = nvs_flash_init();
    if (err == ESP_ERR_NVS_NO_FREE_PAGES || err == ESP_ERR_NVS_NEW_VERSION_FOUND) {
        boot_tracef("nvs init requested erase: 0x%x", (unsigned)err);
        ESP_ERROR_CHECK(nvs_flash_erase());
        err = nvs_flash_init();
    }
    if (err != ESP_OK) boot_tracef("nvs init failed: 0x%x", (unsigned)err);
    ESP_ERROR_CHECK(err);
    boot_trace("nvs init ok");

    // TCP/IP stack and event loop are needed for WiFi (used by web_config).
    boot_trace("netif init begin");
    err = esp_netif_init();
    if (err != ESP_OK) boot_tracef("netif init failed: 0x%x", (unsigned)err);
    ESP_ERROR_CHECK(err);
    boot_trace("netif init ok");

    boot_trace("event loop create begin");
    err = esp_event_loop_create_default();
    if (err != ESP_OK && err != ESP_ERR_INVALID_STATE) boot_tracef("event loop create failed: 0x%x", (unsigned)err);
    if (err != ESP_ERR_INVALID_STATE) ESP_ERROR_CHECK(err);
    boot_trace("event loop create ok");

    // Initialize BLE gamepad parser. Does not start scanning yet —
    // that happens on nimble host sync.
    boot_trace("ble_gamepad_init begin");
    err = ble_gamepad_init();
    if (err != ESP_OK) boot_tracef("ble_gamepad_init failed: 0x%x", (unsigned)err);
    ESP_ERROR_CHECK(err);
    boot_trace("ble_gamepad_init ok");

    // Register the BLE connection-state callback before the web UI starts.
    // Do not start active BLE scanning yet: ESP32-C3 WiFi and BLE share the
    // 2.4GHz radio, and starting a continuous scan before softAP setup can
    // make the config AP hard to see or associate with.
    // NOTE: ble_gamepad_set_connection_callback is registered by web_config_init
    // (later in setup()) because web_config is the only consumer of the
    // broadcast_pending flag. The connection log lines that used to live here
    // were moved into web_config's callback so we keep a single registration site.
    boot_trace("ble callback deferred to web_config_init");

    // Initialize myrobot subsystems (drive motors, S1/S2 aux roles, LEDs, battery, etc.).
    boot_trace("taskManager.begin begin");
    taskManager.begin();
    boot_trace("taskManager.begin ok");

    // Web config — WiFi + async HTTP server + HTML UI.
    // Must come after nvs_flash_init() and esp_netif_init() above.
    // WiFi.begin() may take ~10s if it has to try saved credentials;
    // runs synchronously inside init() to make connection state
    // predictable.
    boot_trace("web_config_init begin");
    err = web_config_init();
    if (err != ESP_OK) boot_tracef("web_config_init failed: 0x%x", (unsigned)err);
    ESP_ERROR_CHECK(err);
    boot_trace("web_config_init ok");

    // Now that the AP/server is initialized, start BLE scanning/bench
    // advertising. This ordering keeps the robot config UI reachable while
    // pairing scans are active.
    boot_trace("ble_gamepad_start begin");
    err = ble_gamepad_start();
    if (err != ESP_OK) boot_tracef("ble_gamepad_start failed: 0x%x", (unsigned)err);
    ESP_ERROR_CHECK(err);
    boot_trace("ble_gamepad_start ok");

    // LED1 pairing-indicator task and the BLE pairing callback. Must be
    // registered after ble_gamepad_start() so the subsystem is live.
    if (g_led1_task == nullptr) {
        xTaskCreatePinnedToCore(
            led1_indicator_task, "led1_pair", 2048, nullptr,
            tskIDLE_PRIORITY + 1, &g_led1_task, APP_CPU_NUM);
    }
    ble_gamepad_set_pairing_callback(on_pairing_state_change);

    // Watchdog: same pattern as v1.3.
    boot_trace("watchdog add begin");
    err = esp_task_wdt_add(NULL);
    if (err != ESP_OK) boot_tracef("watchdog add failed: 0x%x", (unsigned)err);
    ESP_ERROR_CHECK(err);
    boot_trace("setup done");

    // TODO (Phase 2): handle_pairing_button() integration with Buttons class.
}

void loop() {
    // Read the latest gamepad state from ble_gamepad and feed TaskManager.
    // This replaces v1.3's BP32.update() + processControllers() flow but
    // produces the same ControllerState structure.
    ControllerState gs = ble_gamepad_get_state();

    if (g_usb_control_active && millis() - g_usb_last_frame_ms <= USB_CONTROL_TIMEOUT_MS) {
        controllerState = g_usb_controller;
        taskManager.update(true, controllerState);
    } else if (g_usb_control_active) {
        g_usb_control_active = false;
        controllerState = ControllerState{};
        taskManager.update(false, controllerState);
        Serial.println("CLI SAFE usb timeout");
    } else if (ble_gamepad_is_connected()) {
        controllerState.leftStickX    = gs.leftStickX;
        controllerState.leftStickY    = gs.leftStickY;
        controllerState.rightStickX   = gs.rightStickX;
        controllerState.rightStickY   = gs.rightStickY;
        controllerState.rightTrigger  = gs.rightTrigger;
        controllerState.leftTrigger   = gs.leftTrigger;
        controllerState.buttons       = gs.buttons;
        controllerState.dpad          = gs.dpad;
        taskManager.update(true, controllerState);
    } else {
        controllerState.leftStickX    = 0;
        controllerState.leftStickY    = 0;
        controllerState.rightStickX   = 0;
        controllerState.rightStickY   = 0;
        controllerState.rightTrigger  = 0;
        controllerState.leftTrigger   = 0;
        controllerState.buttons       = 0;
        controllerState.dpad          = 0;
        taskManager.update(false, controllerState);
    }

    handle_pairing_button();
    cli_poll();
    ble_gamepad_poll();

    // Service the web_config (WiFi watchdog, future captive portal DNS).
    web_config_loop();

    static uint32_t last_heartbeat_ms = 0;
    uint32_t now = millis();
    if (now - last_heartbeat_ms >= 5000) {
        last_heartbeat_ms = now;
        if (Serial) {
            Serial.printf("[HEARTBEAT %lu] wifi_mode=%d ap_ip=%s sta_ip=%s stations=%d ble_connected=%d pairing=%d\r\n",
                          (unsigned long)now,
                          (int)WiFi.getMode(),
                          WiFi.softAPIP().toString().c_str(),
                          WiFi.localIP().toString().c_str(),
                          WiFi.softAPgetStationNum(),
                          ble_gamepad_is_connected() ? 1 : 0,
                          (int)ble_gamepad_get_pairing_state());
        }
    }

    // Feed the watchdog.
    esp_task_wdt_reset();

    // 50Hz control cadence: responsive enough for combat driving while still
    // yielding to NimBLE, WiFi, AsyncTCP, and the watchdog.
    vTaskDelay(pdMS_TO_TICKS(20));
}
