schwimmbot-create/combat-robot-v2/components/web_config/src/web_config.cpp

// web_config.cpp — Async web server + WiFi manager + HTML UI
//
// First-cut implementation. Covers:
//   * WiFi STA with NVS-saved credentials (fallback to AP on failure)
//   * Async web server on port 80
//   * REST endpoints for status, pairing
//   * Embedded HTML dashboard (PROGMEM)
//   * OTA stub (returns 501; full impl in follow-up)
//
// Deferred to follow-up commits:
//   * Captive portal DNS (currently just prints the AP IP to serial)
//   * Motor/pin/LED config UI
//   * Input mapping editor
//
// SPDX-License-Identifier: Apache-2.0

#include "web_config.h"
#include "ble_gamepad.h"
#include "board_config.h"
#include "board_detect.h"
#include "output_config.h"
#include "battery_config.h"
#include "PowerFunctions.h"
#include "Constants.h"

#include <Arduino.h>
#include <WiFi.h>
#include <ESPAsyncWebServer.h>
#include <AsyncTCP.h>
#include <Update.h>
#include <Preferences.h>
#include <DNSServer.h>
#include <cctype>
#include <cstdlib>
#include "esp_log.h"
#include "nvs_flash.h"
#include "nvs.h"
#include "esp_system.h"
#include "esp_netif.h"
#include "esp_event.h"

static const char *TAG = "web_config";

// NVS namespace for WiFi credentials.
#define WIFI_NVS_NAMESPACE "wifi_creds"
#define NVS_KEY_SSID "ssid"
#define NVS_KEY_PSK  "psk"

// Default AP fallback config (printed to serial on first boot).
// AP password is generated on first boot and stored in NVS; not
// hard-coded for security.
static const char *AP_SSID_PREFIX = "Combat-Robot-";
#define AP_DEFAULT_PASSWORD "fightbot"  // 8+ chars required by spec

// Globals.
static AsyncWebServer *server = nullptr;
static AsyncWebSocket *ws = nullptr;
static DNSServer       dnsServer;     // captive-portal DNS, only active in AP mode
static bool wifi_ap_mode = false;
static char ap_password[32] = AP_DEFAULT_PASSWORD;
// The HTTP response must flush before restarting after a successful OTA.
static uint32_t ota_restart_at_ms = 0;

// Gamepad live state for the WebSocket streamer. Updated each loop tick
// when a client is connected.
static struct {
    bool connected;
    int  lx, ly, rx, ry, lt, rt;
    uint16_t buttons;
    uint16_t dpad;
    uint32_t last_send_ms;
    volatile bool broadcast_pending;
} s_gp = { false, 0, 0, 0, 0, 0, 0, 0, 0, 0, false };

// Connection callback registered with ble_gamepad. Notifies the WS loop
// that there's now something to broadcast.
static void gamepad_ws_event(AsyncWebSocket *server, AsyncWebSocketClient *client,
                             AwsEventType type, void *arg, uint8_t *data, size_t len);
static void gamepad_ws_broadcast_now(void);
static int gamepad_build_state_json(char *buf, size_t buflen);
static void mac_to_cstr(const ble_mac_t *m, char *buf, size_t len);

// The main TU (sketch.cpp) provides the real implementation. A weak
// fallback here keeps the web_config component linkable on its own
// (e.g. for static analysis or unit tests that compile only this TU).
extern "C" __attribute__((weak)) void main_notify_connected(bool /*connected*/) {}
extern "C" __attribute__((weak)) bool main_get_digital_output_logical(int /*output_id*/) { return false; }
extern "C" __attribute__((weak)) bool main_get_digital_output_physical_high(int /*output_id*/) { return false; }
extern "C" __attribute__((weak)) int main_build_runtime_output_json(char *buf, size_t len) {
    if (!buf || len < 3) return -1;
    return snprintf(buf, len, "{\"outputs\":{},\"drive\":{}}");
}

static void on_ble_connection_change(bool connected, const ble_mac_t *mac) {
    // Mirror connect/disconnect to the LED1 pairing indicator. Keeping
    // the shim in sketch.cpp means the web_config component does not
    // have to depend on myrobot/TaskManager. The shim has a weak
    // fallback defined later in this TU so the web_config archive
    // still links on its own.
    main_notify_connected(connected);
    s_gp.connected = connected;
    if (connected) {
        ESP_LOGI(TAG, "BLE controller connected: %02x:%02x:%02x:%02x:%02x:%02x",
                 mac->addr[0], mac->addr[1], mac->addr[2],
                 mac->addr[3], mac->addr[4], mac->addr[5]);
    } else {
        ESP_LOGI(TAG, "BLE controller disconnected");
    }
    if (!connected) {
        // Reset sticks/triggers so the UI doesn't show stale values.
        s_gp.lx = s_gp.ly = s_gp.rx = s_gp.ry = 0;
        s_gp.lt = s_gp.rt = 0;
        s_gp.buttons = s_gp.dpad = 0;
    }
    // NimBLE invokes this callback from its own task. ESPAsyncWebServer /
    // AsyncTCP are not safe to call from here, so only mark the web loop
    // to broadcast on its next tick.
    s_gp.broadcast_pending = true;
}

// --- WebSocket live gamepad feed --------------------------------------

#define GAMEPAD_WS_PATH "/ws"
// Keep the live controller feed below the ESP32/AP/browser drain rate. Sending
// faster than clients can consume creates AsyncWebSocket queue backpressure,
// which shows up in the UI as seconds-old button/stick frames.
#define GAMEPAD_TICK_HZ 20

static void gamepad_ws_event(AsyncWebSocket *server, AsyncWebSocketClient *client,
                             AwsEventType type, void *arg, uint8_t *data, size_t len) {
    if (type == WS_EVT_CONNECT) {
        ESP_LOGI(TAG, "ws client #%u connected from %s", client->id(),
                 client->remoteIP().toString().c_str());
        if (Serial) {
            Serial.printf("[WS] client #%u connected count=%u\r\n",
                          client->id(), ws ? ws->count() : 0);
        }
        char buf[256];
        int n = gamepad_build_state_json(buf, sizeof(buf));
        if (n > 0) client->text(buf, n);
    } else if (type == WS_EVT_DISCONNECT) {
        ESP_LOGI(TAG, "ws client #%u disconnected", client->id());
        if (Serial) {
            Serial.printf("[WS] client #%u disconnected count=%u\r\n",
                          client->id(), ws ? ws->count() : 0);
        }
    }
}

// Build a JSON state message into buf and return the length. Pre-allocated
// 256-byte buffer is plenty for our 9-number state object. Pairing
// state is included so the page can show "ACCEPT" / "IDLE" without
// having to poll /api/status every second.
static int gamepad_build_state_json(char *buf, size_t buflen) {
    struct ControllerState cs = ble_gamepad_get_state();
    ble_mac_t connected_mac;
    char mac_buf[18] = "—";
    if (ble_gamepad_get_connected_mac(&connected_mac)) {
        mac_to_cstr(&connected_mac, mac_buf, sizeof(mac_buf));
    }
    const char *pairing_str = "IDLE";
    switch (ble_gamepad_get_pairing_state()) {
        case PAIRING_STATE_IDLE:     pairing_str = "IDLE";     break;
        case PAIRING_STATE_ACCEPT:   pairing_str = "ACCEPT";   break;
        case PAIRING_STATE_DISABLED: pairing_str = "DISABLED"; break;
    }
    int n = snprintf(buf, buflen,
        "{\"type\":\"state\",\"connected\":%s,\"ble_mac\":\"%s\",\"pairing\":\"%s\","
        "\"state\":{\"lx\":%d,\"ly\":%d,\"rx\":%d,\"ry\":%d,"
                  "\"lt\":%d,\"rt\":%d,"
                  "\"buttons\":%u,\"dpad\":%u}}",
        s_gp.connected ? "true" : "false",
        mac_buf,
        pairing_str,
        cs.leftStickX, cs.leftStickY, cs.rightStickX, cs.rightStickY,
        cs.leftTrigger, cs.rightTrigger,
        (unsigned)cs.buttons, (unsigned)cs.dpad);
    return (n > 0 && (size_t)n < buflen) ? n : -1;
}

// Broadcast a single state frame immediately to all WS clients (used
// right after a pairing-state change so the page reflects it without
// waiting for the next live-feed tick).
static void gamepad_ws_broadcast_now(void) {
    if (!ws) return;
    ws->cleanupClients();
    uint32_t count = ws->count();
    if (count == 0) {
        if (Serial) Serial.printf("[WS] broadcast skipped count=0\r\n");
        return;
    }
    if (!ws->availableForWriteAll()) {
        if (Serial) Serial.printf("[WS] broadcast skipped clients not writable\r\n");
        return;
    }
    s_gp.last_send_ms = millis();
    char buf[256];
    int n = gamepad_build_state_json(buf, sizeof(buf));
    if (n < 0) return;
    ws->textAll(buf);
}

static void gamepad_ws_tick(void) {
    if (!ws) return;
    ws->cleanupClients();
    if (ws->count() == 0) {
        s_gp.broadcast_pending = false;
        return;
    }
    if (!ws->availableForWriteAll()) {
        // Drop this frame instead of queueing stale controller states.
        // The next tick sends the newest state once the client drains.
        s_gp.broadcast_pending = true;
        return;
    }
    uint32_t now = millis();
    bool pending = s_gp.broadcast_pending;
    if (!pending && now - s_gp.last_send_ms < (1000 / GAMEPAD_TICK_HZ)) return;
    s_gp.broadcast_pending = false;
    s_gp.last_send_ms = now;

    char buf[256];
    int n = gamepad_build_state_json(buf, sizeof(buf));
    if (n < 0) return;
    ws->textAll(buf);
}

// --- WiFi credential storage ------------------------------------------

static esp_err_t wifi_load_credentials(char *ssid, size_t ssid_len,
                                       char *psk, size_t psk_len) {
    nvs_handle_t h;
    esp_err_t err = nvs_open(WIFI_NVS_NAMESPACE, NVS_READONLY, &h);
    if (err != ESP_OK) return err;
    err = nvs_get_str(h, NVS_KEY_SSID, ssid, &ssid_len);
    if (err != ESP_OK) { nvs_close(h); return err; }
    err = nvs_get_str(h, NVS_KEY_PSK, psk, &psk_len);
    nvs_close(h);
    return err;
}

static esp_err_t wifi_save_credentials(const char *ssid, const char *psk) {
    nvs_handle_t h;
    esp_err_t err = nvs_open(WIFI_NVS_NAMESPACE, NVS_READWRITE, &h);
    if (err != ESP_OK) return err;
    err = nvs_set_str(h, NVS_KEY_SSID, ssid);
    if (err == ESP_OK) err = nvs_set_str(h, NVS_KEY_PSK, psk);
    if (err == ESP_OK) err = nvs_commit(h);
    nvs_close(h);
    return err;
}

static esp_err_t wifi_clear_credentials(void) {
    nvs_handle_t h;
    esp_err_t err = nvs_open(WIFI_NVS_NAMESPACE, NVS_READWRITE, &h);
    if (err != ESP_OK) return err;
    err = nvs_erase_all(h);
    if (err == ESP_OK) err = nvs_commit(h);
    nvs_close(h);
    return err;
}

// --- HTML (embedded PROGMEM) ------------------------------------------
//
// The production HTML is generated from docs/config-ui-mockup.html by
// tools/gen_web_index.py into web_index_gen.h. That header is included
// here and supplies the canonical `INDEX_HTML[]` symbol.
#include "web_index_gen.h"

// --- JSON helpers -----------------------------------------------------

static void mac_to_cstr(const ble_mac_t *m, char *buf, size_t len) {
    snprintf(buf, len, "%02X:%02X:%02X:%02X:%02X:%02X",
             m->addr[0], m->addr[1], m->addr[2],
             m->addr[3], m->addr[4], m->addr[5]);
}

static String mac_to_string(const ble_mac_t *m) {
    char buf[18];
    mac_to_cstr(m, buf, sizeof(buf));
    return String(buf);
}

static void send_json_status(AsyncWebServerRequest *req) {
    web_status_t s;
    web_config_get_status(&s);

    // Build a paired-macs JSON array.
    ble_mac_t macs[BLE_MAX_PAIRED_CONTROLLERS];
    uint8_t count = 0;
    ble_gamepad_get_paired_macs(macs, &count);

    String json = "{";
    json += "\"ble_connected\":" + String(s.ble_connected ? "true" : "false") + ",";
    json += "\"ble_mac\":\"" + String(s.ble_mac) + "\",";
    json += "\"pairing_state\":\"" + String(s.pairing_state_str) + "\",";
    json += "\"max_paired\":" + String((unsigned)ble_gamepad_get_max_paired()) + ",";
    json += "\"paired_macs\":[";
    for (int i = 0; i < count; i++) {
        if (i > 0) json += ",";
        json += "\"" + mac_to_string(&macs[i]) + "\"";
    }
    json += "],";
    json += "\"wifi_connected\":" + String(s.wifi_connected ? "true" : "false") + ",";
    json += "\"wifi_ap_mode\":" + String(s.wifi_ap_mode ? "true" : "false") + ",";
    json += "\"wifi_ip\":\"" + String(s.wifi_ip) + "\",";
    json += "\"battery_mv\":" + String(s.battery_mv) + ",";
    json += "\"battery_pct\":" + String(s.battery_pct) + ",";
    json += "\"battery_state\":" + String(s.battery_state) + ",";
    json += "\"battery_cell_count\":" + String(s.battery_cell_count) + ",";
    json += "\"battery_cutoff_pct\":" + String(s.battery_cutoff_pct) + ",";
    json += "\"battery_warn_pct\":" + String(s.battery_warn_pct) + ",";
    json += "\"battery_cutoff_mv\":" + String(s.battery_cutoff_mv) + ",";
    json += "\"battery_warn_mv\":" + String(s.battery_warn_mv) + ",";
    json += "\"outputs\":{";
    json += "\"S1\":{\"logical\":" + String(main_get_digital_output_logical(OC_OUT_S1) ? "true" : "false") + ",\"physical_high\":" + String(main_get_digital_output_physical_high(OC_OUT_S1) ? "true" : "false") + "},";
    json += "\"S2\":{\"logical\":" + String(main_get_digital_output_logical(OC_OUT_S2) ? "true" : "false") + ",\"physical_high\":" + String(main_get_digital_output_physical_high(OC_OUT_S2) ? "true" : "false") + "}},";
    static char runtime_json[2048];
    int runtime_n = main_build_runtime_output_json(runtime_json, sizeof(runtime_json));
    json += "\"runtime\":";
    json += runtime_n > 0 ? String(runtime_json) : String("{\"outputs\":{},\"drive\":{}}");
    json += ",";
    json += "\"firmware_version\":\"" + String(s.firmware_version) + "\"";
    json += "}";

    req->send(200, "application/json", json);
}

// --- HTTP route registration -------------------------------------------

static void register_routes(void) {
    server->on("/", HTTP_GET, [](AsyncWebServerRequest *req) {
        AsyncWebServerResponse *resp = req->beginResponse_P(
            200, "text/html",
            reinterpret_cast<const uint8_t *>(INDEX_HTML),
            strlen_P(INDEX_HTML));
        req->send(resp);
    });

    server->on("/api/status", HTTP_GET, send_json_status);

    // Output config (motor direction / servo type / input mapping).
    // Register the longer /api/config/sources path before /api/config;
    // ESPAsyncWebServer route matching can otherwise let the shorter
    // prefix handler consume /api/config/sources.
    server->on("/api/config/sources", HTTP_GET, [](AsyncWebServerRequest *req) {
        static char buf[OC_JSON_BUF_SIZE];
        int n = output_config_sources_to_json(buf, sizeof(buf));
        if (n < 0) {
            req->send(500, "application/json", "{\"err\":\"encode\"}");
            return;
        }
        AsyncWebServerResponse *resp = req->beginResponse(200, "application/json", buf);
        resp->addHeader("Cache-Control", "no-store");
        req->send(resp);
    });

    // Register more-specific /api/config/* routes before /api/config.
    // ESPAsyncWebServer can otherwise let the generic route swallow them.
    server->on("/api/config/battery", HTTP_GET, [](AsyncWebServerRequest *req) {
        static char buf[BC_JSON_BUF_SIZE];
        int n = battery_config_to_json(buf, sizeof(buf));
        if (n < 0) {
            req->send(500, "application/json", "{\"err\":\"encode\"}");
            return;
        }
        AsyncWebServerResponse *resp = req->beginResponse(200, "application/json", buf);
        resp->addHeader("Cache-Control", "no-store");
        req->send(resp);
    });

    server->on("/api/config/battery", HTTP_POST,
        [](AsyncWebServerRequest *req) {
            auto *body = static_cast<String *>(req->_tempObject);
            if (!body) {
                req->send(400, "application/json", "{\"err\":\"no body\"}");
                return;
            }
            esp_err_t err = battery_config_apply_json_patch(body->c_str());
            delete body;
            req->_tempObject = nullptr;
            if (err != ESP_OK) {
                req->send(400, "application/json", "{\"err\":\"invalid battery config\"}");
                return;
            }
            req->send(200, "application/json", "{\"ok\":true}");
        },
        NULL,
        [](AsyncWebServerRequest *req, uint8_t *data, size_t len,
           size_t index, size_t total) {
            if (!req->_tempObject) {
                req->_tempObject = new String();
                static_cast<String *>(req->_tempObject)->reserve(total);
            }
            auto *body = static_cast<String *>(req->_tempObject);
            body->concat(reinterpret_cast<const char *>(data), len);
        });


    server->on("/api/config", HTTP_GET, [](AsyncWebServerRequest *req) {
        static char buf[OC_JSON_BUF_SIZE];
        int n = output_config_to_json(buf, sizeof(buf));
        if (n < 0) {
            req->send(500, "application/json", "{\"err\":\"encode\"}");
            return;
        }
        AsyncWebServerResponse *resp = req->beginResponse(200, "application/json", buf);
        resp->addHeader("Cache-Control", "no-store");
        req->send(resp);
    });

    server->on("/api/config", HTTP_PATCH, [](AsyncWebServerRequest *req) {
        // ESPAsyncWebServer doesn't give us a body for non-body methods
        // consistently. We accept the patch body via header or POST-style.
        // For now we require POST so the form data parser is engaged.
        req->send(405, "application/json", "{\"err\":\"use POST\"}");
    });

    // Buffer the body ourselves. The native "body handler" takes a
    // (uint8_t*, size_t) callback which is awkward for JSON; we collect
    // the body via Upload handler chunks (none expected for the JSON
    // PATCH) and read the raw request URI body via the request callback
    // when the request signals "body parsed".
    //
    // For ESPAsyncWebServer 3.6.0 the simplest contract that returns a
    // body to the server is a `body` handler with the proper signature.
    // The signature is:
    //   void body(AsyncWebServerRequest *req, uint8_t *data, size_t len,
    //             size_t index, size_t total)
    // We accumulate chunks and apply the patch in the final "request"
    // callback when index+len == total.
    server->on("/api/config", HTTP_POST,
        [](AsyncWebServerRequest *req) {
            // Fired after the request (including body) has been parsed.
            // We don't read the body here because the body-handler
            // below stashed it on the request's user context.
            auto *body = static_cast<String *>(req->_tempObject);
            if (!body) {
                req->send(400, "application/json", "{\"err\":\"no body\"}");
                return;
            }
            esp_err_t err = output_config_apply_json_patch(body->c_str());
            delete body;
            req->_tempObject = nullptr;
            if (err != ESP_OK) {
                req->send(400, "application/json", "{\"err\":\"invalid patch\"}");
                return;
            }
            req->send(200, "application/json", "{\"ok\":true}");
        },
        NULL,
        [](AsyncWebServerRequest *req, uint8_t *data, size_t len,
           size_t index, size_t total) {
            if (!req->_tempObject) {
                req->_tempObject = new String();
                static_cast<String *>(req->_tempObject)->reserve(total);
            }
            auto *body = static_cast<String *>(req->_tempObject);
            body->concat(reinterpret_cast<const char *>(data), len);
        });

    server->on("/api/pair/start", HTTP_POST,
        [](AsyncWebServerRequest *req) {
            ble_gamepad_set_pairing_state(PAIRING_STATE_ACCEPT);
            s_gp.broadcast_pending = true;
            req->send(200, "application/json", "{\"ok\":true}");
        },
        NULL
    );

    // Runtime cap on the BLE whitelist. Body: {"max_paired": N} with
    // 1 <= N <= BLE_MAX_PAIRED_CONTROLLERS. Validates, writes to NVS
    // via output_config, then mirrors to ble_gamepad_set_max_paired()
    // so the policy takes effect immediately.
    server->on("/api/config/max_paired", HTTP_POST,
        [](AsyncWebServerRequest *req) {
            // Body handler below accumulates the JSON for us.
            auto *body = static_cast<String *>(req->_tempObject);
            if (!body) {
                req->send(400, "application/json",
                          "{\"err\":\"no body\"}");
                return;
            }
            // Hand-rolled {"max_paired": <digits> } extractor - keep
            // dependency-free like the rest of the web_config glue.
            int n = -1;
            const char *key = "\"max_paired\"";
            const char *p = strstr(body->c_str(), key);
            if (p) {
                p += strlen(key);
                while (*p && *p != ':') p++;
                if (*p == ':') {
                    p++;
                    while (*p && isspace((unsigned char)*p)) p++;
                    char *end = nullptr;
                    long v = strtol(p, &end, 10);
                    if (end != p) n = (int)v;
                }
            }
            delete body;
            req->_tempObject = nullptr;
            if (n < 1 || n > BLE_MAX_PAIRED_CONTROLLERS) {
                req->send(400, "application/json",
                          "{\"err\":\"max_paired must be in [1,"
                          " BLE_MAX_PAIRED_CONTROLLERS]\"}");
                return;
            }
            esp_err_t err = output_config_set_max_paired((uint8_t)n);
            if (err != ESP_OK) {
                req->send(500, "application/json",
                          "{\"err\":\"nvs write failed\"}");
                return;
            }
            err = ble_gamepad_set_max_paired((uint8_t)n);
            if (err != ESP_OK) {
                req->send(500, "application/json",
                          "{\"err\":\"ble set failed\"}");
                return;
            }
            String out = "{\"ok\":true,\"max_paired\":";
            out += String((unsigned)n);
            out += "}";
            req->send(200, "application/json", out);
        },
        NULL,
        [](AsyncWebServerRequest *req, uint8_t *data, size_t len,
           size_t index, size_t total) {
            if (!req->_tempObject) {
                req->_tempObject = new String();
                static_cast<String *>(req->_tempObject)->reserve(total);
            }
            auto *body = static_cast<String *>(req->_tempObject);
            body->concat(reinterpret_cast<const char *>(data), len);
        });

    server->on("/api/pair/cancel", HTTP_POST,
        [](AsyncWebServerRequest *req) {
            ble_gamepad_set_pairing_state(PAIRING_STATE_IDLE);
            s_gp.broadcast_pending = true;
            req->send(200, "application/json", "{\"ok\":true}");
        },
        NULL
    );

    server->on("/api/pair/clear", HTTP_POST,
        [](AsyncWebServerRequest *req) {
            ble_gamepad_clear_paired_macs();
            s_gp.broadcast_pending = true;
            req->send(200, "application/json", "{\"ok\":true}");
        },
        NULL
    );

    // Bench enable/disable endpoints (dev-only; compile-gated).
    server->on("/api/bench/hid/enable", HTTP_POST,
        [](AsyncWebServerRequest *req) {
#ifndef BENCH_HID_PUBLIC
            req->send(404, "application/json", "{\"err\":\"disabled\"}");
#else
            esp_err_t err = ble_gamepad_bench_set_enabled(true);
            req->send(err == ESP_OK ? 200 : 500, "application/json",
                      err == ESP_OK ? "{\"ok\":true,\"enabled\":true}" : "{\"err\":\"enable failed\"}");
#endif
        },
        NULL
    );
    server->on("/api/bench/hid/disable", HTTP_POST,
        [](AsyncWebServerRequest *req) {
#ifndef BENCH_HID_PUBLIC
            req->send(404, "application/json", "{\"err\":\"disabled\"}");
#else
            esp_err_t err = ble_gamepad_bench_set_enabled(false);
            req->send(err == ESP_OK ? 200 : 500, "application/json",
                      err == ESP_OK ? "{\"ok\":true,\"enabled\":false}" : "{\"err\":\"disable failed\"}");
#endif
        },
        NULL
    );
    server->on("/api/bench/hid/status", HTTP_GET,
        [](AsyncWebServerRequest *req) {
#ifdef BENCH_HID_PUBLIC
            bool on = ble_gamepad_bench_is_enabled();
            req->send(200, "application/json",
                      String("{\"build_flag\":true,\"runtime_enabled\":") + (on ? "true" : "false") + "}");
#else
            req->send(200, "application/json", "{\"build_flag\":false,\"runtime_enabled\":false}");
#endif
        },
        NULL
    );

    server->on("/api/bench/battery", HTTP_POST,
        [](AsyncWebServerRequest *req) {
#ifndef BENCH_HID_PUBLIC
            req->send(404, "application/json", "{\"err\":\"disabled\"}");
            return;
#else
            if (req->hasParam("clear")) {
                PowerFunctions::benchClearBatteryOverride();
                req->send(200, "application/json", "{\"ok\":true,\"override\":false}");
                return;
            }
            if (!req->hasParam("state")) {
                req->send(400, "application/json", "{\"err\":\"missing state\"}");
                return;
            }
            String stateName = req->getParam("state")->value();
            stateName.toLowerCase();
            uint8_t state = BATTERY_GOOD;
            uint8_t percent = 100;
            if (stateName == "good" || stateName == "1") {
                state = BATTERY_GOOD;
                percent = 100;
            } else if (stateName == "warn" || stateName == "warning" || stateName == "2") {
                state = BATTERY_WARN;
                percent = battery_config_get_warn_percent();
            } else if (stateName == "low" || stateName == "3") {
                state = BATTERY_LOW;
                percent = battery_config_get_cutoff_percent();
            } else {
                req->send(400, "application/json", "{\"err\":\"bad state\"}");
                return;
            }
            if (req->hasParam("pct")) {
                int pct = req->getParam("pct")->value().toInt();
                if (pct < 0 || pct > 100) {
                    req->send(400, "application/json", "{\"err\":\"bad pct\"}");
                    return;
                }
                percent = (uint8_t)pct;
            }
            PowerFunctions::benchSetBatteryOverride(state, percent);
            req->send(200, "application/json",
                      String("{\"ok\":true,\"override\":true,\"state\":") + state +
                      ",\"pct\":" + percent + "}");
#endif
        },
        NULL
    );

    // Bench HID injection. Disabled in production builds: requires both
    // BENCH_HID_HTTP build flag and an NVS runtime flag.
    server->on("/api/bench/hid", HTTP_POST,
        [](AsyncWebServerRequest *req) {
#ifndef BENCH_HID_PUBLIC
            req->send(404, "application/json", "{\"err\":\"disabled\"}");
            return;
#else
            if (!ble_gamepad_bench_is_enabled()) {
                req->send(403, "application/json", "{\"err\":\"bench disabled\"}");
                return;
            }
            if (!req->hasParam("hex")) {
                req->send(400, "application/json", "{\"err\":\"missing hex\"}");
                return;
            }
            String hex = req->getParam("hex")->value();
            hex.replace(" ", "");
            hex.replace(":", "");
            hex.replace("-", "");
            if ((hex.length() == 0) || ((hex.length() & 1) != 0) || (hex.length() > 128)) {
                req->send(400, "application/json", "{\"err\":\"bad hex length\"}");
                return;
            }
            uint8_t buf[64];
            size_t n = hex.length() / 2;
            auto hexval = [](char c) -> int {
                if (c >= '0' && c <= '9') return c - '0';
                if (c >= 'a' && c <= 'f') return c - 'a' + 10;
                if (c >= 'A' && c <= 'F') return c - 'A' + 10;
                return -1;
            };
            for (size_t i = 0; i < n; i++) {
                int hi = hexval(hex[2 * i]);
                int lo = hexval(hex[2 * i + 1]);
                if (hi < 0 || lo < 0) {
                    req->send(400, "application/json", "{\"err\":\"bad hex\"}");
                    return;
                }
                buf[i] = (uint8_t)((hi << 4) | lo);
            }
            esp_err_t err = ble_gamepad_bench_inject_hid_report(buf, (uint16_t)n);
            if (err != ESP_OK) {
                req->send(400, "application/json", "{\"err\":\"inject failed\"}");
                return;
            }
            s_gp.broadcast_pending = true;
            req->send(200, "application/json", String("{\"ok\":true,\"len\":") + n + "}");
#endif
        },
        NULL
    );

    // Board revision selection. POST /api/board/rev with body
    // "rev=3" or "rev=2" to set the active board revision. Takes
    // effect on next boot. POST /api/board/reset to clear the
    // override and fall back to compile-time BOARD_REV.
    server->on("/api/board/rev", HTTP_POST,
        [](AsyncWebServerRequest *req) {
            // No body params expected for simple set; we look at the
            // URL query string ?rev=N.
            if (!req->hasParam("rev")) {
                req->send(400, "application/json",
                          "{\"err\":\"missing rev parameter\"}");
                return;
            }
            int rev = req->getParam("rev")->value().toInt();
            esp_err_t err = board_detect_set_override(rev);
            if (err != ESP_OK) {
                req->send(400, "application/json",
                          "{\"err\":\"invalid rev (expected 2-255)\"}");
                return;
            }
            req->send(200, "application/json",
                      String("{\"ok\":true,\"rev\":") + rev + "}");
        },
        NULL
    );

    server->on("/api/board/reset", HTTP_POST,
        [](AsyncWebServerRequest *req) {
            esp_err_t err = board_detect_clear_override();
            if (err != ESP_OK) {
                req->send(500, "application/json",
                          "{\"err\":\"clear failed\"}");
                return;
            }
            req->send(200, "application/json", "{\"ok\":true}");
        },
        NULL
    );

    // OTA — accepts a multipart upload at /api/ota.
    server->on("/api/ota", HTTP_POST,
        [](AsyncWebServerRequest *req) {
            bool ok = !Update.hasError();
            req->send(ok ? 200 : 500, "application/json",
                      ok ? "{\"ok\":true}" : "{\"ok\":false,\"err\":\"update\"}");
            if (ok) {
                // Do not block/restart inside AsyncWebServer's request callback:
                // that can tear down the TCP response before the client receives it.
                ota_restart_at_ms = millis() + 1000;
            }
        },
        [](AsyncWebServerRequest *req, const String &filename, size_t index,
           uint8_t *data, size_t len, bool final) {
            if (index == 0) {
                ESP_LOGI(TAG, "OTA: receiving %s", filename.c_str());
                if (!Update.begin(UPDATE_SIZE_UNKNOWN)) {
                    Update.printError(Serial);
                    return;
                }
            }
            if (!Update.write(data, len)) {
                Update.printError(Serial);
                return;
            }
            if (final) {
                if (!Update.end(true)) {
                    Update.printError(Serial);
                }
            }
        }
    );

    // 404 — return JSON for API paths, HTML for others.
    server->onNotFound([](AsyncWebServerRequest *req) {
        if (req->url().startsWith("/api/")) {
            req->send(404, "application/json", "{\"err\":\"not found\"}");
        } else {
            req->redirect("/");
        }
    });
}

// --- WiFi setup --------------------------------------------------------

static void start_ap_mode(void) {
    char ap_ssid[32];
    snprintf(ap_ssid, sizeof(ap_ssid), "%s%04X", AP_SSID_PREFIX,
             (uint16_t)(ESP.getEfuseMac() >> 32) & 0xFFFF);
    WiFi.mode(WIFI_AP);
    bool ok = WiFi.softAP(ap_ssid, ap_password);
    wifi_ap_mode = ok;
    ESP_LOGW(TAG, "Started AP: ok=%d ssid=%s ip=%s channel=%d stations=%d",
             (int)ok,
             ap_ssid,
             WiFi.softAPIP().toString().c_str(),
             WiFi.channel(),
             WiFi.softAPgetStationNum());
    if (Serial) {
        Serial.printf("[WIFI_AP] ok=%d ssid=%s ip=%s channel=%d stations=%d\r\n",
                      (int)ok,
                      ap_ssid,
                      WiFi.softAPIP().toString().c_str(),
                      WiFi.channel(),
                      WiFi.softAPgetStationNum());
    }

    // Captive-portal DNS: respond to every query with our AP IP, so clients
    // hitting "captive.apple.com", "connectivitycheck.gstatic.com", etc.
    // get redirected to our server. Combined with the onNotFound handler
    // above, any URL the user types resolves to /.
    dnsServer.stop();
    dnsServer.setErrorReplyCode(DNSReplyCode::NoError);
    dnsServer.start(53, "*", WiFi.softAPIP());
}

static esp_err_t try_sta_mode(void) {
    char ssid[33] = {0};
    char psk[65] = {0};
    if (wifi_load_credentials(ssid, sizeof(ssid), psk, sizeof(psk)) != ESP_OK) {
        ESP_LOGI(TAG, "No saved WiFi credentials, will start AP");
        return ESP_FAIL;
    }
    ESP_LOGI(TAG, "Trying saved WiFi: %s", ssid);
    WiFi.mode(WIFI_STA);
    WiFi.begin(ssid, psk);
    // Block for up to 10s for connection.
    int attempts = 0;
    while (WiFi.status() != WL_CONNECTED && attempts < 20) {
        delay(500);
        attempts++;
    }
    if (WiFi.status() == WL_CONNECTED) {
        wifi_ap_mode = false;
        ESP_LOGI(TAG, "WiFi connected: %s", WiFi.localIP().toString().c_str());
        return ESP_OK;
    }
    ESP_LOGW(TAG, "WiFi connection failed after 10s, falling back to AP");
    return ESP_FAIL;
}

// --- Public API --------------------------------------------------------

esp_err_t web_config_init(void) {
    ESP_LOGI(TAG, "Initializing web config");

    // Output config must be initialized before we can serve /api/config.
    output_config_init();
    // Mirror the NVS-backed max-paired setting into the BLE subsystem so
    // the runtime policy is active before pairing or auto-reconnect begins.
    ble_gamepad_set_max_paired(output_config_get_max_paired());

    server = new AsyncWebServer(80);
    ws = new AsyncWebSocket(GAMEPAD_WS_PATH);
    ws->onEvent(gamepad_ws_event);
    server->addHandler(ws);

    // BLE gamepad connection callback so we know when to start streaming.
    ble_gamepad_set_connection_callback(on_ble_connection_change);

    // Try STA, fall back to AP.
    if (try_sta_mode() != ESP_OK) {
        start_ap_mode();
    }

    register_routes();
    server->begin();

    ESP_LOGI(TAG, "Web server started on port 80");
    return ESP_OK;
}

void web_config_loop(void) {
    if (ota_restart_at_ms && (int32_t)(millis() - ota_restart_at_ms) >= 0) {
        ota_restart_at_ms = 0;
        ESP.restart();
    }
    // Drain captive-portal DNS requests whenever we're in AP mode.
    if (wifi_ap_mode) {
        dnsServer.processNextRequest();
    }

    // ESPAsyncWebServer runs handlers on its own task. We just need
    // Two cadences:
    //   - WebSocket gamepad feed: every loop tick (designed for ~10–30 Hz)
    //   - WiFi reconnect + client cleanup: every 5 s
    // The previous structure skipped gamepad_ws_tick() inside the 5 s
    // guard, dropping the live feed to ~0.2 Hz.
    static uint32_t last_check = 0;
    uint32_t now = millis();
    gamepad_ws_tick();

    if (now - last_check < 5000) return;
    last_check = now;

    // If we were in STA and got disconnected, fall back to AP.
    if (!wifi_ap_mode && WiFi.status() != WL_CONNECTED) {
        ESP_LOGW(TAG, "WiFi lost, switching to AP mode");
        start_ap_mode();
    }

    // Drain any dead WS clients so count() stays accurate.
    if (ws) ws->cleanupClients();
}

void web_config_get_status(web_status_t *out) {
    memset(out, 0, sizeof(*out));
    out->ble_connected = ble_gamepad_is_connected();
    out->wifi_connected = (WiFi.status() == WL_CONNECTED);
    out->wifi_ap_mode = wifi_ap_mode;
    if (wifi_ap_mode) {
        strncpy(out->wifi_ip, WiFi.softAPIP().toString().c_str(), sizeof(out->wifi_ip) - 1);
    } else {
        strncpy(out->wifi_ip, WiFi.localIP().toString().c_str(), sizeof(out->wifi_ip) - 1);
    }

    ble_mac_t connected_mac;
    if (ble_gamepad_get_connected_mac(&connected_mac)) {
        mac_to_cstr(&connected_mac, out->ble_mac, sizeof(out->ble_mac));
    } else {
        strncpy(out->ble_mac, "—", sizeof(out->ble_mac) - 1);
    }

    switch (ble_gamepad_get_pairing_state()) {
        case PAIRING_STATE_IDLE:     out->pairing_state_str = "IDLE";     break;
        case PAIRING_STATE_ACCEPT:   out->pairing_state_str = "ACCEPT";   break;
        case PAIRING_STATE_DISABLED: out->pairing_state_str = "DISABLED"; break;
    }

    ble_mac_t macs[BLE_MAX_PAIRED_CONTROLLERS];
    uint8_t count = 0;
    ble_gamepad_get_paired_macs(macs, &count);
    snprintf(out->paired_count, sizeof(out->paired_count), "%u", count);

    out->battery_mv = PowerFunctions::getLastBatteryMillivolts();
    out->battery_pct = PowerFunctions::getLastBatteryPercent();
    out->battery_state = PowerFunctions::getLastBatteryState();
    out->battery_cell_count = battery_config_get_cell_count();
    out->battery_cutoff_pct = battery_config_get_cutoff_percent();
    out->battery_warn_pct = battery_config_get_warn_percent();
    out->battery_cutoff_mv = PowerFunctions::battery_cutoff_millivolts(
        out->battery_cell_count,
        out->battery_cutoff_pct);
    out->battery_warn_mv = PowerFunctions::battery_warn_millivolts(
        out->battery_cell_count,
        out->battery_warn_pct);

    out->firmware_version = VERSION;
}
