schwimmbot-create/combat-robot-v2/(commit log)

2026-06-30 Combat Robot v2: ported from combat_robot, NimBLE-based BLE + web UI
    Ported components/myrobot/ from schwimmflugel/esp-idf-arduino-bluepad32-template
    (combat_robot branch, Monster Mash 2025 Combat Version v1.3).
    Replaced Bluepad32 with a NimBLE-based standard HID gamepad parser in
    components/ble_gamepad/. The parser:
    * Auto-discovers HID service 0x1812 and subscribes to input reports
    * Parses standard Bluetooth HID gamepad reports (X/Y/Z/Rz axes,
    16-bit button mask, 2 trigger bytes, hat switch)
    * Rescales axes from 0..255 to -512..511 to match the old BP32 API
    so myrobot/TaskManager.processButtons() and the controller-to-
    motor mapping need no changes
    * Stores up to 4 MA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
    [partitions.csv]
2026-06-30 Add host-side test infrastructure (145 tests, pre-flash gate, CI)
    Built comprehensive test suite to catch regressions before flashing:
    tests/unit/ — pure logic tests (host-runnable, fast)
    - test_hid_parser.py (37 tests): axis scaling math, button bit
    positions, hat switch translation, edge cases, short reports.
    Documents the spec that the C++ parser in components/ble_gamepad/
    must match.
    - test_nvs_whitelist.py (29 tests): add/remove/capacity for the
    NVS-backed MAC whitelist. Edge cases like duplicate adds,
    capacity overflow, invalid input.
    - test_status_api.py (18 tests): JSON shape contract between C++
    /api/status and the HTML dashboard. Catches field name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
    [test_hid_parser.py, test_nvs_whitelist.py, test_pre_flash.py, test_status_api.py, test_structure.py]
2026-06-30 Add board_config.h abstraction layer (v2 + v3 support) and BOARD_HARDWARE.md
    Major scope correction: the chip is an ESP32-C3-MINI-1-H4 (4MB flash),
    NOT an ESP32-WROOM-32 as I previously claimed. The v1.3 firmware
    Constants.h pin defines are wrong for this board — the drum pin
    (ESC_1_PIN=4) is on GPIO4 which is actually SERVO1, the battery
    ADC (BATT_MEAS_PIN=0) is on GPIO0 which is actually MOTOR1_IN1, etc.
    This explains why the v1.3 firmware was probably never actually
    driving the right pins.
    docs/BOARD_HARDWARE.md — new document. Captures:
    - ESP32-C3-MINI-1-H4 pad map and strapping pins
    - v2 and v3 board pin assignments (extracted from schematic)
    - Side-by-side: what v1.3 had vs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
    [board_config.h, test_board_config.py, test_pre_flash.py]
2026-06-30 Add v3 BLDC breakout (CN5) support: 4 motor drivers, 7-pin header, 50Hz servo PWM
    Major documentation and code updates for v2 vs v3 board differences:
    docs/BOARD_HARDWARE.md - expanded with:
    - Section 4: Motor Driver Topology (the KEY difference)
    * v2 board: 2x DRV8871 (U5, U6), 2 motor outputs (P1, P2), NO spare header
    * v3 board: 4x DRV8871DDAR (U7-U10), 4 motor outputs (P1-P4), AND
    a CN5 'Spare output header for motor pins' (WAFER-SH1.0-5PLB, 7 pads)
    - Section 4.1: CN5 pinout (GND, MOTOR1_IN1, MOTOR1_IN2, MOTOR2_IN2,
    MOTOR2_IN1, GND, GND) confirmed from rendered schematic
    - Section 4.2: What CN5 is for - external BLDC ESCs, or any other
    external driver that ta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
    [board-v2-rev1-schematic.epro, board-v3-rev1-schematic.epro]
2026-07-01 Add runtime board detection (3-layer: NVS > hardware > compile-time)
    New module: board_detect.h/cpp in components/board_config/
    Approach: 2 GPIO strapping pins read at boot, bit pattern identifies
    the board. NVS override (set via web UI) takes priority. Compile-time
    BOARD_REV=N is the fallback. So the same binary can run on v2 or v3
    hardware without -DBOARD_REV=N at build time.
    Why this approach over alternatives:
    - ADC divider: only 1 free ADC pin (GPIO3 is battery). Conflicts.
    - eFuse/I2C probe: same ESP32 chip on both boards, same IMU.
    Can't distinguish v2 from v3.
    - Compile-time only: requires remembering to change -DBOARD_REV
    when flashing v3 hardware. Easy to forget and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
2026-07-01 Simplify board_detect to NVS-only (Option 1)
    The user pointed out that I was building out the hardware-strapping
    detection (Option 2) without first asking if they actually had free
    GPIOs for it. They chose Option 1: NVS override only.
    Removed:
    - BOARD_ID_GPIO0/BOARD_ID_GPIO1 macros
    - gpio_get_level() / gpio_config() calls
    - The 3-layer priority (NVS > hardware > compile-time)
    - v4/v5 future IDs (since we only have v2 and v3)
    Kept:
    - NVS read/write/clear of 'board_config' / 'rev_override' key
    - Fallback to compile-time BOARD_REV
    - Same API surface: active_rev(), set_override(), clear_override(),
    has_override(), id_to_rev()
    Added:
    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
2026-07-01 Build config updates for attempted flash: pin platform, drop bogus NimBLE dep, gitignore build artifacts
    The user's request to flash the board surfaced several build config
    issues that needed fixing before the build could even start:
    platformio.ini:
    - Pin platform to espressif32@6.5.0 (uses ESP-IDF 5.1.x)
    Reason: Arduino-esp32 as a component only supports ESP-IDF 5.1.x
    (5.1.0-5.1.99). The 'latest dev' branch uses ESP-IDF 5.4 which
    breaks the arduino-as-component pattern.
    - lib_deps: switch from mehlma/ESPAsyncWebServer (not in PIO registry)
    to me-no-dev/ESPAsyncWebServer (canonical owner)
    - lib_deps: remove h2eng/nimble (NimBLE is bundled in ESP-IDF, not
    a separate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
2026-07-02 BLE+WiFi+web UI overhaul: NimBLE-Arduino, output_config component, tabbed mobile web UI, WebSocket live feed, captive portal
    - Replace Bluepad32 with NimBLE-Arduino (@1.4.2) for standard HID gamepads (8BitDo Ultimate 2 + others).
    - Migrate Arduino-ESP32 2.0.14 LEDC APIs to explicit channels.
    - 4MB partition table (esp32c3 C3-MINI).
    - New output_config component: 5 logical outputs (M1/M2/Weapon/S1/S2), 24 input sources, per-output direction toggle + servo uni/bi + deadzone + primary/secondary source mapping; persisted in NVS namespace 'output_cfg' v1.
    - web_config: AsyncWebServer REST endpoints (GET /api/config, /api/config/sources, POST /api/config), AsyncWebSocket at /ws streaming controlle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
    [partitions.csv]
2026-07-02 Documentation: rewrite README + add AGENT.md / CHANGELOG.md; refresh BUILD/TESTING/DECISIONS for chunks 1-5
    README.md: rewrite as the canonical entry point. Removed the stale v1.3
    'first cut' status table; updated paths, names, and feature list to
    match what's actually on disk. Tabs/features/status match the
    chunk-1..5 firmware already on COM6.
    docs/AGENT.md (NEW): the 'pick up the codebase cold' guide.
    Architecture diagram, file-map-for-what, hard constraints (ESP32-C3 is
    BLE-only, no ArduinoJson, no framework=espidf, no editing
    web_index_gen.h by hand, always use --rts 0 --dtr 0 on the monitor),
    hidden gotchas, and how to add each kind of feature.
    docs/CHANGELOG.md (NEW): single-source l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
2026-07-02 Fix pairing state not visible in web UI
    User reported: clicking 'Enter Pairing Mode' on the Controller tab
    does not show the pairing state changing on the page. Root cause:
    WebSocket feed only carried connected/axis/trigger/button data, not
    the pairing state, so until a controller actually connected the page
    got stuck on 'Controller off' / 'IDLE' even after the user clicked
    the button.
    Fix:
    - web_config.cpp: gamepad_build_state_json() now includes a
    'pairing' field ('IDLE' | 'ACCEPT' | 'DISABLED').
    - New gamepad_ws_broadcast_now() helper pushes a state frame
    immediately rather than waiting up to 33 ms for the next 30 Hz tick.
    - /api/pair/{start,cancel,clear} handlers call broadcast_now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
    [ble_gamepad.cpp, test_output_config.py, web_config.cpp]
2026-07-03 fix: stabilize 8BitDo BLE pairing on ESP32-C3
    - Defer BLE connect out of the NimBLE scan callback and service scan slices from loop
    - Add 8BitDo security/passkey setup, Report Map warmup read, and multi-report characteristic discovery
    - Keep boot scanning deferred so the SoftAP and web UI remain reachable
    - Defer WebSocket broadcasts out of NimBLE callbacks and enlarge output-config JSON buffer
    - Add/update regression tests for pairing state, route ordering, and safe WS broadcasts
    Verified:
    - PlatformIO build succeeds for esp32-c3-devkitc-02
    - pytest: 263 passed, 4 skipped
    - Real 8BitDo Ultimate 2 paired and stayed connected via /api/status and /ws
    [ble_gamepad.cpp, ble_gamepad.h, output_config.h, sketch.cpp, test_output_config.py, web_config.cpp]
2026-07-03 fix: clarify output mapping UI and config save
    [output_config.c, test_output_config.py]
2026-07-03 fix: sanitize output config save payload
    [test_output_config.py]
2026-07-03 fix: auto-reconnect bonded controller + correct LT/RT mapping
    [ble_gamepad.cpp, test_output_config.py, web_config.cpp]
2026-07-04 fix: decode 8BitDo Ultimate 2 BLE input reports + auto-reconnect by name
    Live 8BitDo Ultimate 2 BLE HID reports were decoded as zeros because:
    1. the firmware only subscribed to the first notifiable Report char (id=2),
    while real input arrives on the second notifiable char (id=1, handle 29);
    2. the parser expected a generic HID layout, not the 8BitDo
    (hat, LX, LY, RX, RY, R2, L2, buttons0, buttons1, ...) shape;
    3. auto-reconnect was gated by exact BLE MAC, so a controller that
    rotates its BD_ADDR (AE -> AF after a power cycle) was rejected.
    This patch:
    * enumerates all notifiable/indicatable HID input report characteristics,
    using the Report Reference descriptor (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
    [ble_gamepad.cpp, ble_gamepad.h, pc_ble_bench.py, test_output_config.py, web_config.cpp]
2026-07-04 tools: add BLE/GATT and HIDAPI recorders for 8BitDo reverse engineering
    tools/ble_hid_recorder.py: Windows BLE GATT recorder. Connects to the
    8BitDo, pauses for the Windows pairing approval dialog, enumerates
    services, prefers notifiable HID Report chars (then vendor notify
    chars as fallback), and writes JSONL + console log + summary. Includes
    connect retries and per-subscribe timeouts so a missing HID service
    does not hang the script.
    tools/hidapi_gamepad_recorder.py: Windows HIDAPI recorder used when
    BLE GATT reports are absent. Walks 12 manual phases with Enter advance
    (no time-based transitions), writes timestamped JSONL + console log +
    summary, supports --verbose for terminal per-repor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
    [ble_hid_recorder.py, hidapi_gamepad_recorder.py]
2026-07-04 fix: harden controller page status and paired-list rendering
    The Controller page could appear stale after pairing/clearing because the BLE header only listened to WebSocket state frames. Drive the header from /api/status as well, initialize it on first paint, and defensively clamp partial gamepad/config data so malformed or partial API/WS frames cannot crash rendering.
    Changes:
    - call setBle(false) during boot before renderOutputs()
    - call setBle(!!s.ble_connected) in applyStatus()
    - seed missing output config rows before reading cfg.direction
    - clamp partial state.gp fields in liveTick()
    - guard buttons/dpad in renderButtonChips()
    - regenerate embedded web_index_gen.h
    - add HTML regression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
    [test_output_config.py]
2026-07-04 fix: prevent WebSocket controller-state backlog
    The controller page could show button/stick changes several seconds late because the ESPAsyncWebServer WebSocket client queue filled while broadcasting state frames at 30Hz from the ESP32 AP.
    Avoid queuing stale controller frames:
    - lower GAMEPAD_TICK_HZ from 30Hz to 20Hz
    - cleanup dead WS clients before immediate and tick broadcasts
    - check availableForWriteAll() before textAll()
    - drop/retry pending frames when clients are not writable instead of queueing stale state
    - add regression tests for the live feed rate and backpressure guards
    Verification:
    - python -m pytest tests/integration/test_output_config.py -q -> 72 passed
    - platformio run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
    [test_output_config.py, web_config.cpp]
2026-07-04 fix: align output config defaults with tank drive mapping
    Actual runtime drive remains hard-coded tank drive: left motor from leftStickY, right motor from rightStickY. HID Y-up decodes negative and TaskManager reverses the forward input range so negative Y maps to positive FORWARD PWM.
    Align setup metadata and UI with that reality:
    - default M2 drive input is now RY instead of LY
    - output source comments distinguish left/right drive Y axes
    - Outputs tab discloses that runtime motor routing is still fixed tank drive and config is saved for setup/diagnostics only
    - add regressions for the negative-Y-forward sign chain and fixed-runtime warning
    Verificati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
    [output_config.c, output_config.h, test_output_config.py]
2026-07-04 feat: add selectable drive modes
    Add a live drive-mode setting persisted in output_config NVS and exposed through /api/config. The Outputs tab now has a Driving Style selector with four presets:
    - tank_split: left stick Y drives left side, right stick Y drives right side
    - arcade_left: left stick Y throttle, left stick X steering
    - arcade_right: right stick Y throttle, right stick X steering
    - arcade_split: left stick Y throttle, right stick X steering
    TaskManager reads output_config_get_drive_mode() each control update and switches between the existing two_stick_drive() tank mixer and combined_direction() arcade mixer. The drive mode can be changed from HTML and saved without reflashing.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
2026-07-04 test: add mock robot drive preview and simulator
    Add a host-side mock robot drive simulator that mirrors the firmware drive math from TaskManager/Drive/DriveMotor. The CLI accepts normalized controller axes and a drive mode, then emits JSON left/right motor direction and PWM so control mappings can be tested without putting the robot on blocks.
    Also add a live Mock robot output preview to the Outputs tab. It uses the current WebSocket controller state and selected drive mode to show left/right motor direction and PWM bars for tank_split, arcade_left, arcade_right, and arcade_split.
    Tests cover:
    - tank split maps LY/RY to independent sides
    - arcade modes bind the intended throttle/turn axes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
2026-07-04 tools: make gen_web_index.py cross-platform
    The pre-build script was hard-coded to
    C:\Users\kbrow\Documents\Codex\combat-robot-v2
    which fails on Linux/macOS/CI and on PlatformIO's SCons pre-script
    execution (where `__file__` is stripped from globals by SCons'
    `exec()`).
    Resolve PROJECT_ROOT from a sequence of candidates:
    1. PROJECT_ROOT env var (escape hatch for CI / non-standard layouts)
    2. Current working directory (PlatformIO runs SCons from project root)
    3. `__file__` / `sys.argv[0]` / `co_filename` from the running script
    4. Kevin's literal Windows path (laptop-only fallback)
    Tested both direct invocation (`python tools/gen_web_index.py`) and
    under SCons-style `exec()` — b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
    [gen_web_index.py]
2026-07-04 fix: gate bench GATT service behind BENCH_HID_PUBLIC
    The UUID_BENCH_SERVICE was created and advertised on every boot,
    regardless of whether BENCH_HID_PUBLIC was defined. The bench write
    characteristic accepts WRITE | WRITE_NR with no authentication and
    no MITM protection — anyone in BLE range who knows the UUID can
    write synthetic HID frames and drive the robot (including the
    weapon).
    Now matches the HTTP-side bench endpoints under /api/bench/, which
    were already gated. Default builds no longer expose the bench GATT
    characteristic at all; dev builds with `-D BENCH_HID_PUBLIC=1`
    behave exactly as before.
    Also re-includes the earlier `#ifdef BENCH_HID_PUBLIC` guard wrap
    on the bench functi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
    [ble_gamepad.cpp]
2026-07-04 fix: harden parse_hid_report dispatch and 8BitDo no-report-id branch
    Three real bugs in parse_hid_report() (components/ble_gamepad/src/ble_gamepad.cpp):
    1. No upper bound on incoming `len` at function entry. parse_8bitdo_report
    reads up to data[base+8] and parse_standard_hid_report reads up to
    data[8]; a malformed short report (len < 10) could dereference OOB.
    Added `if (len < 10) return;` at the top.
    2. The no-report-id branch required `len > 12`, silently dropping
    10–12 byte 8BitDo reports. The dispatcher would fall through to
    parse_standard_hid_report, which reads the wrong byte as the hat/dpad
    byte (resulting in spurious d-pad up-right being constantly pressed).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
    [test_output_config.py]
2026-07-04 fix: avoid 1-byte stack overflow in output_config key copy
    `if (klen >= sizeof(key)) return ESP_ERR_INVALID_ARG;` allowed a
    klen of 24 (sizeof(key)) to pass the check and then
    `memcpy(key, key_start, 24)` would write past the buffer (the NUL
    terminator at key[24] is past the array). The adjacent stack
    variable (`body` const char*) was clobbered, causing
    apply_patch_one() to read from an arbitrary address — exploitable
    by any AP client posting a JSON PATCH with a 24-char key.
    Change to `klen >= sizeof(key) - 1` so the memcpy is bounded by
    23 bytes (with the trailing NUL still inside the 24-byte buffer).
    Bug surfaced by the 2026-07-04 memory/concurrency static review.
    [output_config.c]
2026-07-04 fix: restore 10–30 Hz WebSocket gamepad feed and unify BLE callback
    Two related bugs in web_config_loop() / sketch.cpp:
    1. gamepad_ws_tick() was guarded inside a 5-second throttle that
    early-returned before the WS tick ran, dropping the live feed to
    ~0.2 Hz from the designed 30 Hz. Inverted the structure so
    gamepad_ws_tick() runs every loop tick and only the WiFi reconnect
    check + WS cleanupClients() are throttled.
    2. `ble_gamepad_set_connection_callback` was called from two places
    (sketch.cpp:153 and web_config.cpp:634). The API overwrites the
    stored pointer, so the sketch's callback (which only logged) was
    silently replaced by web_config's callback (which sets
    s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
    [sketch.cpp, web_config.cpp]
2026-07-04 fix: declare output_config_source_from_str in public header
    The function is defined at output_config.c:430 and called internally
    by output_config_apply_json_patch at lines 497 and 501, but its
    declaration was missing from output_config.h. Any future caller in a
    different translation unit would fail at link time with an undefined
    reference. Adds the declaration alongside output_config_source_name.
    [output_config.h]
2026-07-04 Documentation: log known issues from 2026-07-04 three-agent review
    Adds a 'Known issues (deferred)' section to CHANGELOG.md listing the
    findings from the bug-hunt / security / memory-concurrency agents
    that were not fixed in this session — each needs its own design pass
    or follow-up commits.
    Security follow-ups (require user-facing config migration):
    - Hard-coded AP password 'fightbot' + zero API auth
    - BLE Just-Works pairing with mitm=false, hardcoded passkey 000000
    Bug-hunt follow-ups (style / latent):
    - BoardConfig class referenced but never defined
    - No extern C guards on C++ headers consumed by C
    - rgbLED.h #pragma once inconsistency
    Memory follow-ups (need runtime valida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
2026-07-04 tools: add Makefile + QUICKSTART.md for Linux build box
    Makefile wraps PlatformIO + pytest + pc_ble_bench.py into single-
    command targets (make setup / build / flash / monitor / test /
    bench-scan / bench-write / ota / clean). Honors ENV=, PORT=, BAUD=,
    BENCH_MAC= overrides. Defaults to Linux conventions (/dev/ttyACM0)
    rather than Windows (COM6).
    QUICKSTART.md is the short version of docs/AGENT.md for getting
    unblocked on a fresh Linux checkout — toolchain matrix, build envs,
    first-flash checklist, BLE bench workflow.
    .venv/ is intentionally NOT committed — it's the project-local
    Python 3.12 venv with platformio + pytest + bleak. Run `make setup`
    on a fresh clone to recreate.
    Tested on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
2026-07-04 tools: add cross-platform build and flash wrapper
    Add tools/dev.py as the canonical cross-platform entrypoint for setup, tests, firmware build, flashing, serial monitor, clean, and BLE bench helpers. The wrapper resolves .venv executables correctly on Windows (Scripts/*.exe), Linux, and macOS (bin/*), provides OS defaults for serial ports, and falls back to host PlatformIO/pytest installs when a project venv has not been created yet.
    Update the Makefile to delegate to tools/dev.py instead of hard-coding .venv/bin paths, and rewrite QUICKSTART.md with Linux/macOS/Windows commands plus serial-port guidance. Ignore .venv/ in git.
    - python -m pytest tests/unit/test_dev_tool.py -q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
    [dev.py, test_dev_tool.py]
2026-07-04 fix: enforce one-controller BLE whitelist and protect controller_state from torn reads
    Set BLE_MAX_PAIRED_CONTROLLERS from 4 to 1 to match Kevin's stated model
    (one paired controller at a time until reset = pair a new controller).
    Rewrote ble_gamepad_add_paired_mac() to overwrite slot 0 when at capacity
    instead of returning ESP_ERR_NO_MEM, so the user's only reset path —
    pairing a new controller — actually works. BLE_MAX_PAIRED_CONTROLLERS
    remains a #define for now; a follow-up will make the runtime cap HTML
    configurable (default 1).
    Wrapped the field writes in parse_8bitdo_report / parse_standard_hid_report
    and ble_gamepad_get_state() in portENTER_CRITICAL / portEXIT_CRITICAL,
    guarded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
    [ble_gamepad.cpp, ble_gamepad.h, test_nvs_whitelist.py]
2026-07-04 chore: add extern "C" guards and standardise rgbLED.h include guard
    boards_config.h, board_detect.h, web_config.h, and ble_gamepad.h are
    consumed by both .c and .cpp translation units (e.g. main/sketch.cpp
    calls into board_config helpers, the wifi subsystem calls into
    web_config). Without extern "C" linkage, those calls were resolving
    through C++ name mangling and compiling only because of accidental
    ABI compatibility on this toolchain. Wrapping the C-callable surface
    in extern "C" { } makes the contract explicit and portable across
    toolchains / new ESP-IDF versions.
    rgbLED.h had only #pragma once. Add a matching #ifndef RGBLED_H /
    #define RGBLED_H ... #endif wrapper for project consistency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
2026-07-04 fix: increase TaskManager stack from 4096 to 6144 bytes
    managerTask calls combined_direction / two_stick_drive /
    adjustLedForBattery (which allocates the rainbow color buffer)
    under one stack frame. With CONFIG_ARDUINO_RUNNING_CORE = 1 (single
    core) and configUSE_STACK_OVERFLOW_CHECK enabled in FreeRTOS, 4096
    bytes was firing the stack-overflow canary under sustained rainbow
    animation. 6144 is well clear of the canary while still leaving
    plenty of headroom in the 32 KB task memory budget.
    Verified: build succeeds, 296 tests pass.
    [TaskManager.cpp]
2026-07-04 feat(ble): runtime whitelist cap, user-configurable from web UI
    The BLE whitelist was hard-coded to BLE_MAX_PAIRED_CONTROLLERS, which
    served only as the compile-time array cap. Kevin's stated model is
    'one paired controller at a time until reset', but the storage layer
    made the cap a global #define with no runtime override and no way to
    ever run with more than one controller. The HTML UI also had no way
    to surface the policy.
    Split the policy into three layers:
    BLE_MAX_PAIRED_CONTROLLERS = 4 // compile-time array cap (storage)
    BLE_RUNTIME_MAX_PAIRED_DEFAULT = 1 // default when NVS is absent
    BLE_RUNTIME_MAX_PAIRED_CAP = 4 // user-configurable upper bound
    New API on ble_gamepad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
    [ble_gamepad.cpp, ble_gamepad.h, test_nvs_whitelist.py, test_structure.py]
2026-07-04 feat(output_config): persist max_paired runtime cap
    Add a runtime BLE whitelist cap to the existing output_config NVS namespace.
    The new key is max_paired_v1, stored separately from the cfg_v1 per-output
    blob for the same reason drive_v1 is separate: old cfg_v1 blobs remain valid
    and missing/invalid values can fall back cleanly.
    New public API:
    uint8_t output_config_get_max_paired(void);
    esp_err_t output_config_set_max_paired(uint8_t n);
    Semantics:
    - default: OC_MAX_PAIRED_DEFAULT = 1
    - valid range: 1..OC_MAX_PAIRED_CAP (4)
    - save_all() persists blob + drive_mode + max_paired atomically
    - output_config_init() loads max_paired if present and sane, otherwise 1
    - output_config_r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
    [output_config.c, output_config.h, test_output_config.py]
2026-07-04 feat(ui): add Controller tab max paired cap control
    Add a numeric Max paired controllers control to the Controller tab's Pairing
    card. The field is constrained to 1..4 in the browser, matching
    BLE_RUNTIME_MAX_PAIRED_CAP, and defaults to 1 in the client-side state.
    UI behavior:
    - /api/status hydration mirrors s.max_paired into state.max_paired and the
    input without overwriting while the input is focused
    - /api/config load also pre-fills the input from j.max_paired
    - Save Cap posts JSON to /api/config/max_paired: { max_paired: raw }
    - success updates state, marks the inline status as saved, toasts, and
    refreshes status
    - invalid values show inline status + error toast before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
    [test_output_config.py]
2026-07-04 test: allow intentional rgbLED header guard change
    The current GitHub head includes 13f33bb, which standardises rgbLED.h's include guard and adds extern C guards. That intentionally breaks the byte-identical v1 fixture check, so move rgbLED.h to INTENTIONALLY_MODIFIED_FILES with the matching reason.
    - python tools/dev.py test -> 322 passed, 8 skipped
    - python tools/dev.py build --env esp32-c3-devkitc-02-dev -> SUCCESS
    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
    [test_structure.py]
2026-07-04 fix(web): serve embedded HTML with explicit PROGMEM length
    At current head, /api/status and /api/config responded from the flashed board, but GET / accepted the TCP connection and sent zero bytes until timeout. Replace the deprecated req->send_P root handler with an explicit beginResponse_P response using strlen_P(INDEX_HTML), then send that response.
    Add an integration guard requiring the root HTML route to use beginResponse_P with explicit INDEX_HTML length instead of send_P.
    - python -m pytest tests/integration/test_output_config.py::TestOutputConfigBuildWiring::test_root_html_route_uses_explicit_progmem_response_length -q -> 1 passed
    - python tools/dev.py test -> 323 pass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
    [test_output_config.py, web_config.cpp]
2026-07-04 fix(web): update controller MAC live
    [ble_gamepad.cpp, ble_gamepad.h, test_output_config.py, web_config.cpp]
2026-07-04 feat(web): show board v2 output inventory
2026-07-04 fix(web): make output input assignment explicit
    [test_output_config.py]
2026-07-04 fix(led): blink LED1 during pairing
    [ble_gamepad.cpp, ble_gamepad.h, sketch.cpp, test_output_config.py, web_config.cpp]
2026-07-04 fix(led): stop blinking after successful pair
    [ble_gamepad.cpp, test_output_config.py]
2026-07-04 feat(button): hold SW1 5s to clear and pair
2026-07-05 fix(gpio): align LED1 and SW1 pins with board v2
    [Constants.h, LED.cpp, test_output_config.py, test_structure.py]
2026-07-05 fix(gpio): restore live v2 LED1 and SW1 pins
    [Constants.h, board_config.h, test_board_config.py, test_output_config.py, test_pre_flash.py]
2026-07-05 fix(button): let SW1 hold reach 5s pairing
    [Buttons.cpp, Buttons.h, test_output_config.py, test_structure.py]
2026-07-05 fix(ble): accept short HID input reports promptly
    [ble_gamepad.cpp, test_output_config.py]
2026-07-05 fix(control): run main loop at 50hz
    [sketch.cpp, test_pre_flash.py]
2026-07-05 feat(battery): expose configurable cutoff telemetry
2026-07-05 fix(control): isolate drive motor pwm channels
    [Constants.h, Drive.cpp, DriveMotor.cpp, DriveMotor.h, test_output_config.py, test_structure.py, web_config.cpp]
2026-07-05 feat(battery): allow 1-8 cell packs
2026-07-06 fix(battery): readable state labels and dirty-input guard
    [test_output_config.py]
2026-07-06 fix(battery): stop wiping dirty flags on status poll
    [test_output_config.py]
2026-07-07 Refactor outputs to four-channel role model
    Remove the dedicated Weapon output and legacy Drum runtime, keep M1/M2 drive-only, and make S1/S2 role-configurable for servo, ESC, weapon_esc, digital, and accessory use.\n\nAdds schema/API/UI validation for obsolete Weapon rejection, S1/S2 pulse runtime via PulseOutput, expanded bench coverage, and regenerated embedded config UI.\n\nVerified with pytest, PlatformIO upload, and tools/bench_e2e.py.
2026-07-07 Refine aux ESC and servo protocol UI
    Remove the separate Weapon ESC purpose from the UI/contract, treat weapon behavior as an ESC safety role, add RC servo PPM protocol support, and reset pulse defaults when protocols change.\n\nMoves pulse calibration into a collapsed advanced section and updates tests/docs/bench expectations.\n\nVerified with full pytest, PlatformIO build/upload, and hardware bench_e2e.
    [TaskManager.cpp, bench_e2e.py, output_config.c, output_config.h, test_output_config_v2_schema.py, test_output_role_runtime.py, test_output_role_ui.py, test_power_policy_runtime.py]
2026-07-07 Add configurable ESC arming sequences
    Add manual, boot-time, and hold-source ESC arming modes for S1/S2 ESC outputs. Automatic modes emit configurable low-high-low arming pulses before throttle commands are accepted; manual mode leaves sequencing to the user. Expose the controls in the web UI, persist them through /api/config, and cover them in tests and hardware bench API checks.
2026-07-07 Expose ESC arming telemetry for bench tests
    Add S1/S2 pulse/duty/arming phase to serial status, parse it in the hardware bench, and use the USB S3 mock controller to verify hold-to-arm ESC sequencing through waiting, holding, high-pulse, armed, and post-arm throttle tracking.
2026-07-07 Add expanded servo and ESC pulse protocols
    Add additional servo PWM rates, ESC PWM rates, OneShot, OneShot42, and MultiShot presets across schema, runtime, UI, generated web assets, tests, and hardware bench coverage.
2026-07-07 Add manual motor output mode
    Move output guidance into info popups, bound M1/M2 PWM frequency, and add Drive Method None so M1/M2 can be controlled individually for proportional, momentary, or latching behavior. Update UI, runtime, schema, tests, and bench coverage.
2026-07-07 Refine configurator UI and power behavior
2026-07-07 Collapse power behavior cards by default
2026-07-14 feat: expand robot output configuration and bench validation
    [partitions.csv]
